CalPlug/EVSE_Smart_Charger/2017-2018 Project/EVSE_Processing_Interface/evse/images/textBox4.jpg

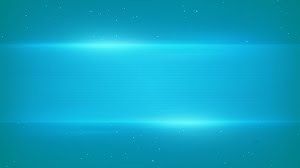
2017-2018 Project/EVSE_Processing_Interface/evse/images/textBox4.jpg
