CalPlug/EVSE_Smart_Charger/2017-2018 Project/Smartenit_Board_I2C/README

This is an updated board and schematics to a more readable format and includes a header for I2C.
