CalPlug/EVSE_Smart_Charger/2017-2018 Project/FPGA Design/Microsemi_SmartFusion2_FutureCreativeBoard_BaseDesign-master/FCBBaseDesign/synthesis/synlog/report/SF2_MSS_sys_fpga_mapper_notes.txt

@N: MF248 |Running in 64-bit mode.
@N: MF667 |Clock conversion disabled. (Command "set_option -fix_gated_and_generated_clocks 0" in the project file.)
@N: MO111 :"c:\users\mike klopfer\documents\github\microsemi_smartfusion2_futurecreativeboard_basedesign\fcbbasedesign\component\actel\directcore\corepwm\4.3.101\rtl\vhdl\core\reg_if.vhd":316:27:316:99|Tristate driver un1_tri7 (in view: corepwm_lib.corepwm_reg_if(trans)) on net un1_tri7 (in view: corepwm_lib.corepwm_reg_if(trans)) has its enable tied to GND.
@N: MO111 :"c:\users\mike klopfer\documents\github\microsemi_smartfusion2_futurecreativeboard_basedesign\fcbbasedesign\component\actel\directcore\corepwm\4.3.101\rtl\vhdl\core\reg_if.vhd":316:27:316:99|Tristate driver un1_tri6 (in view: corepwm_lib.corepwm_reg_if(trans)) on net un1_tri6 (in view: corepwm_lib.corepwm_reg_if(trans)) has its enable tied to GND.
@N: MO111 :"c:\users\mike klopfer\documents\github\microsemi_smartfusion2_futurecreativeboard_basedesign\fcbbasedesign\component\actel\directcore\corepwm\4.3.101\rtl\vhdl\core\reg_if.vhd":316:27:316:99|Tristate driver un1_tri5 (in view: corepwm_lib.corepwm_reg_if(trans)) on net un1_tri5 (in view: corepwm_lib.corepwm_reg_if(trans)) has its enable tied to GND.
@N: MO111 :"c:\users\mike klopfer\documents\github\microsemi_smartfusion2_futurecreativeboard_basedesign\fcbbasedesign\component\actel\directcore\corepwm\4.3.101\rtl\vhdl\core\reg_if.vhd":316:27:316:99|Tristate driver un1_tri4 (in view: corepwm_lib.corepwm_reg_if(trans)) on net un1_tri4 (in view: corepwm_lib.corepwm_reg_if(trans)) has its enable tied to GND.
@N: MO111 :"c:\users\mike klopfer\documents\github\microsemi_smartfusion2_futurecreativeboard_basedesign\fcbbasedesign\component\actel\directcore\corepwm\4.3.101\rtl\vhdl\core\reg_if.vhd":316:27:316:99|Tristate driver un1_tri3 (in view: corepwm_lib.corepwm_reg_if(trans)) on net un1_tri3 (in view: corepwm_lib.corepwm_reg_if(trans)) has its enable tied to GND.
@N: MO111 :"c:\users\mike klopfer\documents\github\microsemi_smartfusion2_futurecreativeboard_basedesign\fcbbasedesign\component\actel\directcore\corepwm\4.3.101\rtl\vhdl\core\reg_if.vhd":316:27:316:99|Tristate driver un1_tri2 (in view: corepwm_lib.corepwm_reg_if(trans)) on net un1_tri2 (in view: corepwm_lib.corepwm_reg_if(trans)) has its enable tied to GND.
@N: MO111 :"c:\users\mike klopfer\documents\github\microsemi_smartfusion2_futurecreativeboard_basedesign\fcbbasedesign\component\actel\directcore\corepwm\4.3.101\rtl\vhdl\core\reg_if.vhd":316:27:316:99|Tristate driver un1_tri1 (in view: corepwm_lib.corepwm_reg_if(trans)) on net un1_tri1 (in view: corepwm_lib.corepwm_reg_if(trans)) has its enable tied to GND.
@N: MO111 :"c:\users\mike klopfer\documents\github\microsemi_smartfusion2_futurecreativeboard_basedesign\fcbbasedesign\component\actel\directcore\corepwm\4.3.101\rtl\vhdl\core\reg_if.vhd":316:27:316:99|Tristate driver un1_tri0 (in view: corepwm_lib.corepwm_reg_if(trans)) on net un1_tri0 (in view: corepwm_lib.corepwm_reg_if(trans)) has its enable tied to GND.
@N: MO111 :"c:\users\mike klopfer\documents\github\microsemi_smartfusion2_futurecreativeboard_basedesign\fcbbasedesign\component\actel\directcore\corepwm\4.3.101\rtl\vhdl\core\reg_if.vhd":314:27:314:98|Tristate driver un1_psh_enable_reg1_tri7 (in view: corepwm_lib.corepwm_reg_if(trans)) on net un1_psh_enable_reg1_tri7 (in view: corepwm_lib.corepwm_reg_if(trans)) has its enable tied to GND.
@N: MO111 :"c:\users\mike klopfer\documents\github\microsemi_smartfusion2_futurecreativeboard_basedesign\fcbbasedesign\component\actel\directcore\corepwm\4.3.101\rtl\vhdl\core\reg_if.vhd":314:27:314:98|Tristate driver un1_psh_enable_reg1_tri6 (in view: corepwm_lib.corepwm_reg_if(trans)) on net un1_psh_enable_reg1_tri6 (in view: corepwm_lib.corepwm_reg_if(trans)) has its enable tied to GND.
@N: MO106 :"c:\users\mike klopfer\documents\github\microsemi_smartfusion2_futurecreativeboard_basedesign\fcbbasedesign\component\actel\directcore\coreapb3\4.1.100\rtl\vhdl\core\coreapb3.vhd":648:12:648:15|Found ROM .delname. (in view: work.SF2_MSS_sys_sb(rtl)) with 16 words by 5 bits.
@N: BN362 :"c:\users\mike klopfer\documents\github\microsemi_smartfusion2_futurecreativeboard_basedesign\fcbbasedesign\component\actel\directcore\corespi\5.1.104\rtl\vhdl\core\spi_chanctrl.vhd":371:8:371:9|Removing sequential instance mtx_consecutive (in view: corespi_lib.spi_chanctrl(trans)) of type view:PrimLib.dffre(prim) because it does not drive other instances.
@N: MF135 :"c:\users\mike klopfer\documents\github\microsemi_smartfusion2_futurecreativeboard_basedesign\fcbbasedesign\component\actel\directcore\coregpio\3.1.101\rtl\vhdl\core\coregpio.vhd":521:8:521:9|RAM GEN_BITS\.0\.REG_GEN\.CONFIG_reg[7:0] (in view: coregpio_lib.CoreGPIO(rtl)) is 16 words by 8 bits.
@N: BN362 :"c:\users\mike klopfer\documents\github\microsemi_smartfusion2_futurecreativeboard_basedesign\fcbbasedesign\component\actel\directcore\coregpio\3.1.101\rtl\vhdl\core\coregpio.vhd":521:8:521:9|Removing sequential instance CONFIG_reg_0[2] (in view: coregpio_lib.CoreGPIO(rtl)) of type view:PrimLib.dffr(prim) because it does not drive other instances.
@N: BN362 :"c:\users\mike klopfer\documents\github\microsemi_smartfusion2_futurecreativeboard_basedesign\fcbbasedesign\component\actel\directcore\coregpio\3.1.101\rtl\vhdl\core\coregpio.vhd":521:8:521:9|Removing sequential instance CONFIG_reg_1[2] (in view: coregpio_lib.CoreGPIO(rtl)) of type view:PrimLib.dffr(prim) because it does not drive other instances.
@N: BN362 :"c:\users\mike klopfer\documents\github\microsemi_smartfusion2_futurecreativeboard_basedesign\fcbbasedesign\component\actel\directcore\coregpio\3.1.101\rtl\vhdl\core\coregpio.vhd":521:8:521:9|Removing sequential instance CONFIG_reg_2[2] (in view: coregpio_lib.CoreGPIO(rtl)) of type view:PrimLib.dffr(prim) because it does not drive other instances.
@N: BN362 :"c:\users\mike klopfer\documents\github\microsemi_smartfusion2_futurecreativeboard_basedesign\fcbbasedesign\component\actel\directcore\coregpio\3.1.101\rtl\vhdl\core\coregpio.vhd":521:8:521:9|Removing sequential instance CONFIG_reg_3[2] (in view: coregpio_lib.CoreGPIO(rtl)) of type view:PrimLib.dffr(prim) because it does not drive other instances.
@N: BN362 :"c:\users\mike klopfer\documents\github\microsemi_smartfusion2_futurecreativeboard_basedesign\fcbbasedesign\component\actel\directcore\coregpio\3.1.101\rtl\vhdl\core\coregpio.vhd":521:8:521:9|Removing sequential instance CONFIG_reg_4[2] (in view: coregpio_lib.CoreGPIO(rtl)) of type view:PrimLib.dffr(prim) because it does not drive other instances.
@N: BN362 :"c:\users\mike klopfer\documents\github\microsemi_smartfusion2_futurecreativeboard_basedesign\fcbbasedesign\component\actel\directcore\coregpio\3.1.101\rtl\vhdl\core\coregpio.vhd":521:8:521:9|Removing sequential instance CONFIG_reg_5[2] (in view: coregpio_lib.CoreGPIO(rtl)) of type view:PrimLib.dffr(prim) because it does not drive other instances.
@N: BN362 :"c:\users\mike klopfer\documents\github\microsemi_smartfusion2_futurecreativeboard_basedesign\fcbbasedesign\component\actel\directcore\coregpio\3.1.101\rtl\vhdl\core\coregpio.vhd":521:8:521:9|Removing sequential instance CONFIG_reg_6[2] (in view: coregpio_lib.CoreGPIO(rtl)) of type view:PrimLib.dffr(prim) because it does not drive other instances.
@N: BN362 :"c:\users\mike klopfer\documents\github\microsemi_smartfusion2_futurecreativeboard_basedesign\fcbbasedesign\component\actel\directcore\coregpio\3.1.101\rtl\vhdl\core\coregpio.vhd":521:8:521:9|Removing sequential instance CONFIG_reg_7[2] (in view: coregpio_lib.CoreGPIO(rtl)) of type view:PrimLib.dffr(prim) because it does not drive other instances.
@N: BN362 :"c:\users\mike klopfer\documents\github\microsemi_smartfusion2_futurecreativeboard_basedesign\fcbbasedesign\component\actel\directcore\coregpio\3.1.101\rtl\vhdl\core\coregpio.vhd":521:8:521:9|Removing sequential instance CONFIG_reg_8[2] (in view: coregpio_lib.CoreGPIO(rtl)) of type view:PrimLib.dffr(prim) because it does not drive other instances.
@N: BN362 :"c:\users\mike klopfer\documents\github\microsemi_smartfusion2_futurecreativeboard_basedesign\fcbbasedesign\component\actel\directcore\coregpio\3.1.101\rtl\vhdl\core\coregpio.vhd":521:8:521:9|Removing sequential instance CONFIG_reg_9[2] (in view: coregpio_lib.CoreGPIO(rtl)) of type view:PrimLib.dffr(prim) because it does not drive other instances.
@N: BN362 :"c:\users\mike klopfer\documents\github\microsemi_smartfusion2_futurecreativeboard_basedesign\fcbbasedesign\component\actel\directcore\coregpio\3.1.101\rtl\vhdl\core\coregpio.vhd":521:8:521:9|Removing sequential instance CONFIG_reg_10[2] (in view: coregpio_lib.CoreGPIO(rtl)) of type view:PrimLib.dffr(prim) because it does not drive other instances.
@N: BN362 :"c:\users\mike klopfer\documents\github\microsemi_smartfusion2_futurecreativeboard_basedesign\fcbbasedesign\component\actel\directcore\coregpio\3.1.101\rtl\vhdl\core\coregpio.vhd":521:8:521:9|Removing sequential instance CONFIG_reg_11[2] (in view: coregpio_lib.CoreGPIO(rtl)) of type view:PrimLib.dffr(prim) because it does not drive other instances.
@N: MO231 :"c:\users\mike klopfer\documents\github\microsemi_smartfusion2_futurecreativeboard_basedesign\fcbbasedesign\component\actel\directcore\corepwm\4.3.101\rtl\vhdl\core\timebase.vhd":75:6:75:7|Found counter in view:corepwm_lib.corepwm_timebase(trans) instance period_cnt_int[15:0] 
@N: MO231 :"c:\users\mike klopfer\documents\github\microsemi_smartfusion2_futurecreativeboard_basedesign\fcbbasedesign\component\actel\directcore\corepwm\4.3.101\rtl\vhdl\core\timebase.vhd":58:6:58:7|Found counter in view:corepwm_lib.corepwm_timebase(trans) instance prescale_cnt[15:0] 
@N: MF179 :"c:\users\mike klopfer\documents\github\microsemi_smartfusion2_futurecreativeboard_basedesign\fcbbasedesign\component\actel\directcore\corepwm\4.3.101\rtl\vhdl\core\timebase.vhd":83:19:83:45|Found 16 by 16 bit equality operator ('==') un17_prescale_cnt (in view: corepwm_lib.corepwm_timebase(trans))
@N: MF179 :"c:\users\mike klopfer\documents\github\microsemi_smartfusion2_futurecreativeboard_basedesign\fcbbasedesign\component\actel\directcore\corepwm\4.3.101\rtl\vhdl\core\pwm_gen.vhd":75:26:75:154|Found 16 by 16 bit equality operator ('==') PWM_output_select\.1\.PWM_output_generation\.un11_pwm_enable_reg (in view: corepwm_lib.corepwm_pwm_gen(trans))
@N: MF179 :"c:\users\mike klopfer\documents\github\microsemi_smartfusion2_futurecreativeboard_basedesign\fcbbasedesign\component\actel\directcore\corepwm\4.3.101\rtl\vhdl\core\pwm_gen.vhd":75:163:75:239|Found 16 by 16 bit equality operator ('==') PWM_output_select\.1\.PWM_output_generation\.un14_pwm_enable_reg (in view: corepwm_lib.corepwm_pwm_gen(trans))
@N: MF179 :"c:\users\mike klopfer\documents\github\microsemi_smartfusion2_futurecreativeboard_basedesign\fcbbasedesign\component\actel\directcore\corepwm\4.3.101\rtl\vhdl\core\pwm_gen.vhd":75:26:75:154|Found 16 by 16 bit equality operator ('==') PWM_output_select\.2\.PWM_output_generation\.un49_pwm_enable_reg (in view: corepwm_lib.corepwm_pwm_gen(trans))
@N: MF179 :"c:\users\mike klopfer\documents\github\microsemi_smartfusion2_futurecreativeboard_basedesign\fcbbasedesign\component\actel\directcore\corepwm\4.3.101\rtl\vhdl\core\pwm_gen.vhd":75:163:75:239|Found 16 by 16 bit equality operator ('==') PWM_output_select\.2\.PWM_output_generation\.un52_pwm_enable_reg (in view: corepwm_lib.corepwm_pwm_gen(trans))
@N: MF179 :"c:\users\mike klopfer\documents\github\microsemi_smartfusion2_futurecreativeboard_basedesign\fcbbasedesign\component\actel\directcore\corepwm\4.3.101\rtl\vhdl\core\pwm_gen.vhd":75:26:75:154|Found 16 by 16 bit equality operator ('==') PWM_output_select\.3\.PWM_output_generation\.un87_pwm_enable_reg (in view: corepwm_lib.corepwm_pwm_gen(trans))
@N: MF179 :"c:\users\mike klopfer\documents\github\microsemi_smartfusion2_futurecreativeboard_basedesign\fcbbasedesign\component\actel\directcore\corepwm\4.3.101\rtl\vhdl\core\pwm_gen.vhd":75:163:75:239|Found 16 by 16 bit equality operator ('==') PWM_output_select\.3\.PWM_output_generation\.un90_pwm_enable_reg (in view: corepwm_lib.corepwm_pwm_gen(trans))
@N: MF179 :"c:\users\mike klopfer\documents\github\microsemi_smartfusion2_futurecreativeboard_basedesign\fcbbasedesign\component\actel\directcore\corepwm\4.3.101\rtl\vhdl\core\pwm_gen.vhd":79:82:79:158|Found 16 by 16 bit equality operator ('==') PWM_output_select\.1\.PWM_output_generation\.un31_pwm_enable_reg (in view: corepwm_lib.corepwm_pwm_gen(trans))
@N: MF179 :"c:\users\mike klopfer\documents\github\microsemi_smartfusion2_futurecreativeboard_basedesign\fcbbasedesign\component\actel\directcore\corepwm\4.3.101\rtl\vhdl\core\pwm_gen.vhd":79:82:79:158|Found 16 by 16 bit equality operator ('==') PWM_output_select\.2\.PWM_output_generation\.un69_pwm_enable_reg (in view: corepwm_lib.corepwm_pwm_gen(trans))
@N: MF179 :"c:\users\mike klopfer\documents\github\microsemi_smartfusion2_futurecreativeboard_basedesign\fcbbasedesign\component\actel\directcore\corepwm\4.3.101\rtl\vhdl\core\pwm_gen.vhd":79:82:79:158|Found 16 by 16 bit equality operator ('==') PWM_output_select\.3\.PWM_output_generation\.un107_pwm_enable_reg (in view: corepwm_lib.corepwm_pwm_gen(trans))
@N: MO231 :"c:\users\mike klopfer\documents\github\microsemi_smartfusion2_futurecreativeboard_basedesign\fcbbasedesign\component\actel\directcore\corespi\5.1.104\rtl\vhdl\core\spi_chanctrl.vhd":683:8:683:9|Found counter in view:corespi_lib.spi_chanctrl(trans) instance stxs_bitcnt[4:0] 
@N: MO231 :"c:\users\mike klopfer\documents\github\microsemi_smartfusion2_futurecreativeboard_basedesign\fcbbasedesign\component\actel\directcore\corespi\5.1.104\rtl\vhdl\core\spi_chanctrl.vhd":683:8:683:9|Found counter in view:corespi_lib.spi_chanctrl(trans) instance stxs_bitsel[4:0] 
@N: MO231 :"c:\users\mike klopfer\documents\github\microsemi_smartfusion2_futurecreativeboard_basedesign\fcbbasedesign\component\actel\directcore\corespi\5.1.104\rtl\vhdl\core\spi_chanctrl.vhd":371:8:371:9|Found counter in view:corespi_lib.spi_chanctrl(trans) instance mtx_bitsel[4:0] 
@N: MO231 :"c:\users\mike klopfer\documents\github\microsemi_smartfusion2_futurecreativeboard_basedesign\fcbbasedesign\component\actel\directcore\corespi\5.1.104\rtl\vhdl\core\spi_chanctrl.vhd":270:8:270:9|Found counter in view:corespi_lib.spi_chanctrl(trans) instance spi_clk_count[7:0] 
@N: MO225 :"c:\users\mike klopfer\documents\github\microsemi_smartfusion2_futurecreativeboard_basedesign\fcbbasedesign\component\work\sf2_mss_sys_sb\coreuartapb_0\rtl\vhdl\core\coreuart.vhd":367:6:367:7|There are no possible illegal states for state machine rx_state[0:3] (in view: coreuartapb_lib.SF2_MSS_sys_sb_CoreUARTapb_0_COREUART(translated)); safe FSM implementation is not required.
@N: FX403 :"c:\users\mike klopfer\documents\github\microsemi_smartfusion2_futurecreativeboard_basedesign\fcbbasedesign\component\work\sf2_mss_sys_sb\coreuartapb_0\rtl\vhdl\core\fifo_256x8.vhd":343:10:343:15|Property "block_ram" or "no_rw_check" found for RAM UG07\.rx_fifo_xhdl80.fifo_ctrl_256_xhdl9.ram16x8_xhdl12.memory_xhdl3[7:0] with specified coding style. Inferring block RAM.
@N: FX403 :"c:\users\mike klopfer\documents\github\microsemi_smartfusion2_futurecreativeboard_basedesign\fcbbasedesign\component\work\sf2_mss_sys_sb\coreuartapb_0\rtl\vhdl\core\fifo_256x8.vhd":343:10:343:15|Property "block_ram" or "no_rw_check" found for RAM UG06a\.tx_fifo_xhdl79.fifo_ctrl_256_xhdl9.ram16x8_xhdl12.memory_xhdl3[7:0] with specified coding style. Inferring block RAM.
@N: MO231 :"c:\users\mike klopfer\documents\github\microsemi_smartfusion2_futurecreativeboard_basedesign\fcbbasedesign\component\work\sf2_mss_sys_sb\coreuartapb_0\rtl\vhdl\core\clock_gen.vhd":214:11:214:12|Found counter in view:coreuartapb_lib.SF2_MSS_sys_sb_CoreUARTapb_0_Clock_gen(rtl) instance baud_cntr[12:0] 
@N: MO225 :"c:\users\mike klopfer\documents\github\microsemi_smartfusion2_futurecreativeboard_basedesign\fcbbasedesign\component\work\sf2_mss_sys_sb\coreuartapb_0\rtl\vhdl\core\rx_async.vhd":264:6:264:7|There are no possible illegal states for state machine rx_state[0:3] (in view: coreuartapb_lib.SF2_MSS_sys_sb_CoreUARTapb_0_Rx_async(translated)); safe FSM implementation is not required.
@N: BN362 :"c:\users\mike klopfer\documents\github\microsemi_smartfusion2_futurecreativeboard_basedesign\fcbbasedesign\component\actel\directcore\corespi\5.1.104\rtl\vhdl\core\spi_chanctrl.vhd":270:8:270:9|Removing sequential instance SF2_MSS_sys_sb_0.CORESPI_0.USPI.UCC.spi_clk_next (in view: work.SF2_MSS_sys(rtl)) because it does not drive other instances.
@N: BN362 :"c:\users\mike klopfer\documents\github\microsemi_smartfusion2_futurecreativeboard_basedesign\fcbbasedesign\component\actel\directcore\corei2c\7.2.101\rtl\vhdl\core\corei2creal.vhd":1553:8:1553:9|Removing sequential instance SF2_MSS_sys_sb_0.COREI2C_0.G0a\.0\.ui2c.fsmsync[0] (in view: work.SF2_MSS_sys(rtl)) because it does not drive other instances.
@N: BN362 :|Removing sequential instance SF2_MSS_sys_sb_0.CoreUARTapb_0.uUART.UG06a\.tx_fifo_xhdl79.fifo_ctrl_256_xhdl9.ram16x8_xhdl12.memory_xhdl3_memory_xhdl3_0_0_R[0] (in view: work.SF2_MSS_sys(rtl)) of type view:ACG4.SLE(PRIM) because it does not drive other instances.
@N: BN362 :|Removing sequential instance SF2_MSS_sys_sb_0.CoreUARTapb_0.uUART.UG06a\.tx_fifo_xhdl79.fifo_ctrl_256_xhdl9.ram16x8_xhdl12.memory_xhdl3_memory_xhdl3_0_0_R[1] (in view: work.SF2_MSS_sys(rtl)) of type view:ACG4.SLE(PRIM) because it does not drive other instances.
@N: BN362 :|Removing sequential instance SF2_MSS_sys_sb_0.CoreUARTapb_0.uUART.UG06a\.tx_fifo_xhdl79.fifo_ctrl_256_xhdl9.ram16x8_xhdl12.memory_xhdl3_memory_xhdl3_0_0_R[2] (in view: work.SF2_MSS_sys(rtl)) of type view:ACG4.SLE(PRIM) because it does not drive other instances.
@N: BN362 :|Removing sequential instance SF2_MSS_sys_sb_0.CoreUARTapb_0.uUART.UG06a\.tx_fifo_xhdl79.fifo_ctrl_256_xhdl9.ram16x8_xhdl12.memory_xhdl3_memory_xhdl3_0_0_R[3] (in view: work.SF2_MSS_sys(rtl)) of type view:ACG4.SLE(PRIM) because it does not drive other instances.
@N: BN362 :|Removing sequential instance SF2_MSS_sys_sb_0.CoreUARTapb_0.uUART.UG06a\.tx_fifo_xhdl79.fifo_ctrl_256_xhdl9.ram16x8_xhdl12.memory_xhdl3_memory_xhdl3_0_0_R[4] (in view: work.SF2_MSS_sys(rtl)) of type view:ACG4.SLE(PRIM) because it does not drive other instances.
@N: BN362 :|Removing sequential instance SF2_MSS_sys_sb_0.CoreUARTapb_0.uUART.UG06a\.tx_fifo_xhdl79.fifo_ctrl_256_xhdl9.ram16x8_xhdl12.memory_xhdl3_memory_xhdl3_0_0_R[5] (in view: work.SF2_MSS_sys(rtl)) of type view:ACG4.SLE(PRIM) because it does not drive other instances.
@N: BN362 :|Removing sequential instance SF2_MSS_sys_sb_0.CoreUARTapb_0.uUART.UG06a\.tx_fifo_xhdl79.fifo_ctrl_256_xhdl9.ram16x8_xhdl12.memory_xhdl3_memory_xhdl3_0_0_R[6] (in view: work.SF2_MSS_sys(rtl)) of type view:ACG4.SLE(PRIM) because it does not drive other instances.
@N: BN362 :|Removing sequential instance SF2_MSS_sys_sb_0.CoreUARTapb_0.uUART.UG06a\.tx_fifo_xhdl79.fifo_ctrl_256_xhdl9.ram16x8_xhdl12.memory_xhdl3_memory_xhdl3_0_0_R[7] (in view: work.SF2_MSS_sys(rtl)) of type view:ACG4.SLE(PRIM) because it does not drive other instances.
@N: BN362 :|Removing sequential instance SF2_MSS_sys_sb_0.CoreUARTapb_0.uUART.UG07\.rx_fifo_xhdl80.fifo_ctrl_256_xhdl9.ram16x8_xhdl12.memory_xhdl3_memory_xhdl3_0_0_R[0] (in view: work.SF2_MSS_sys(rtl)) of type view:ACG4.SLE(PRIM) because it does not drive other instances.
@N: BN362 :|Removing sequential instance SF2_MSS_sys_sb_0.CoreUARTapb_0.uUART.UG07\.rx_fifo_xhdl80.fifo_ctrl_256_xhdl9.ram16x8_xhdl12.memory_xhdl3_memory_xhdl3_0_0_R[1] (in view: work.SF2_MSS_sys(rtl)) of type view:ACG4.SLE(PRIM) because it does not drive other instances.
@N: BN362 :|Removing sequential instance SF2_MSS_sys_sb_0.CoreUARTapb_0.uUART.UG07\.rx_fifo_xhdl80.fifo_ctrl_256_xhdl9.ram16x8_xhdl12.memory_xhdl3_memory_xhdl3_0_0_R[2] (in view: work.SF2_MSS_sys(rtl)) of type view:ACG4.SLE(PRIM) because it does not drive other instances.
@N: BN362 :|Removing sequential instance SF2_MSS_sys_sb_0.CoreUARTapb_0.uUART.UG07\.rx_fifo_xhdl80.fifo_ctrl_256_xhdl9.ram16x8_xhdl12.memory_xhdl3_memory_xhdl3_0_0_R[3] (in view: work.SF2_MSS_sys(rtl)) of type view:ACG4.SLE(PRIM) because it does not drive other instances.
@N: BN362 :|Removing sequential instance SF2_MSS_sys_sb_0.CoreUARTapb_0.uUART.UG07\.rx_fifo_xhdl80.fifo_ctrl_256_xhdl9.ram16x8_xhdl12.memory_xhdl3_memory_xhdl3_0_0_R[4] (in view: work.SF2_MSS_sys(rtl)) of type view:ACG4.SLE(PRIM) because it does not drive other instances.
@N: BN362 :|Removing sequential instance SF2_MSS_sys_sb_0.CoreUARTapb_0.uUART.UG07\.rx_fifo_xhdl80.fifo_ctrl_256_xhdl9.ram16x8_xhdl12.memory_xhdl3_memory_xhdl3_0_0_R[5] (in view: work.SF2_MSS_sys(rtl)) of type view:ACG4.SLE(PRIM) because it does not drive other instances.
@N: BN362 :|Removing sequential instance SF2_MSS_sys_sb_0.CoreUARTapb_0.uUART.UG07\.rx_fifo_xhdl80.fifo_ctrl_256_xhdl9.ram16x8_xhdl12.memory_xhdl3_memory_xhdl3_0_0_R[6] (in view: work.SF2_MSS_sys(rtl)) of type view:ACG4.SLE(PRIM) because it does not drive other instances.
@N: BN362 :|Removing sequential instance SF2_MSS_sys_sb_0.CoreUARTapb_0.uUART.UG07\.rx_fifo_xhdl80.fifo_ctrl_256_xhdl9.ram16x8_xhdl12.memory_xhdl3_memory_xhdl3_0_0_R[7] (in view: work.SF2_MSS_sys(rtl)) of type view:ACG4.SLE(PRIM) because it does not drive other instances.
@N: FP130 |Promoting Net SF2_MSS_sys_sb_0.MSS_READY on CLKINT  I_210 
@N: FX1056 |Writing EDF file: C:\Users\Mike Klopfer\Documents\GitHub\Microsemi_SmartFusion2_FutureCreativeBoard_BaseDesign\FCBBaseDesign\synthesis\SF2_MSS_sys.edn
@N: BW103 |The default time unit for the Synopsys Constraint File (SDC or FDC) is 1ns.
@N: BW107 |Synopsys Constraint File capacitance units using default value of 1pF 
@N: MT615 |Found clock SF2_MSS_sys_sb_0/FABOSC_0/I_RCOSC_25_50MHZ/CLKOUT with period 20.00ns 
@N: MT615 |Found clock SF2_MSS_sys_sb_0/CCC_0/GL0 with period 14.29ns 
@N: MT615 |Found clock SF2_MSS_sys_sb_0/CCC_0/GL1 with period 1000.00ns 
@N: MT320 |This timing report is an estimate of place and route data. For final timing results, use the FPGA vendor place and route report.
@N: MT322 |Clock constraints include only register-to-register paths associated with each individual clock.
@N: MT582 |Estimated period and frequency not reported for given clock unless the clock has at least one timing path which is not a false or a max delay path and that does not have excessive slack
