CalPlug/EVSE_Smart_Charger/2017-2018 Project/FPGA Design/Microsemi_SmartFusion2_FutureCreativeBoard_BaseDesign-master/FCBBaseDesign/synthesis/synlog/report/SF2_MSS_sys_fpga_mapper_hier_area.csv

. Module name | SLE | CFG | ARI1 | BUFFER | MACC | RAM1K18 | RAM64X18 | GLOBAL | IO
. SF2_MSS_sys | 970 | 1561 | 237 | 0 | 0 | 0 | 9 | 4 | 52
. . SF2_MSS_sys_sb | 970 | 1561 | 237 | 0 | 0 | 0 | 9 | 4 | 2
. . . CoreAPB3 | 0 | 286 | 0 | 0 | 0 | 0 | 0 | 0 | 0
. . . . COREAPB3_MUXPTOB3 | 0 | 282 | 0 | 0 | 0 | 0 | 0 | 0 | 0
. . . CoreGPIO | 180 | 301 | 0 | 0 | 0 | 0 | 1 | 0 | 0
. . . CoreResetP | 9 | 2 | 0 | 0 | 0 | 0 | 0 | 1 | 0
. . . SF2_MSS_sys_sb_CCC_0_FCCC | 0 | 0 | 0 | 0 | 0 | 0 | 0 | 3 | 0
. . . SF2_MSS_sys_sb_COREI2C_0_COREI2C | 119 | 344 | 0 | 0 | 0 | 0 | 0 | 0 | 0
. . . . COREI2C_COREI2CREAL | 111 | 342 | 0 | 0 | 0 | 0 | 0 | 0 | 0
. . . SF2_MSS_sys_sb_CoreUARTapb_0_CoreUARTapb | 171 | 212 | 19 | 0 | 0 | 0 | 2 | 0 | 0
. . . . SF2_MSS_sys_sb_CoreUARTapb_0_COREUART | 147 | 175 | 19 | 0 | 0 | 0 | 2 | 0 | 0
. . . . . SF2_MSS_sys_sb_CoreUARTapb_0_Clock_gen | 19 | 10 | 14 | 0 | 0 | 0 | 0 | 0 | 0
. . . . . SF2_MSS_sys_sb_CoreUARTapb_0_Rx_async | 39 | 74 | 0 | 0 | 0 | 0 | 0 | 0 | 0
. . . . . SF2_MSS_sys_sb_CoreUARTapb_0_Tx_async | 23 | 24 | 5 | 0 | 0 | 0 | 0 | 0 | 0
. . . . . SF2_MSS_sys_sb_CoreUARTapb_0_fifo_256x8 | 21 | 21 | 0 | 0 | 0 | 0 | 1 | 0 | 0
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
