CalPlug/EVSE_Smart_Charger/2016 Project/EVSE_DEMO_MATLAB_GUI/PC EVSE DEMO/OpenEVSE_RAPI_Processing_GUI/RGB_LCD.jpg

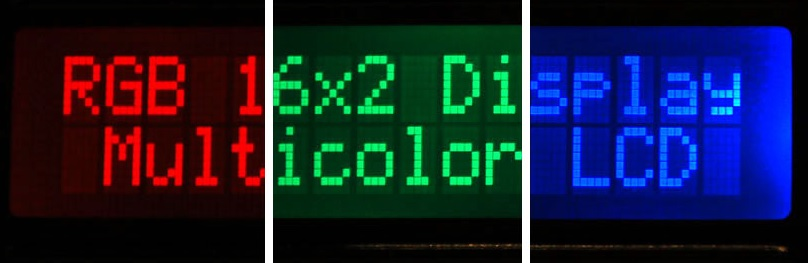
2016 Project/EVSE_DEMO_MATLAB_GUI/PC EVSE DEMO/OpenEVSE_RAPI_Processing_GUI/RGB_LCD.jpg
