CalPlug/EVSE_Smart_Charger/2017-2018 Project/EVSE code/Arduino/MQTT_example.png

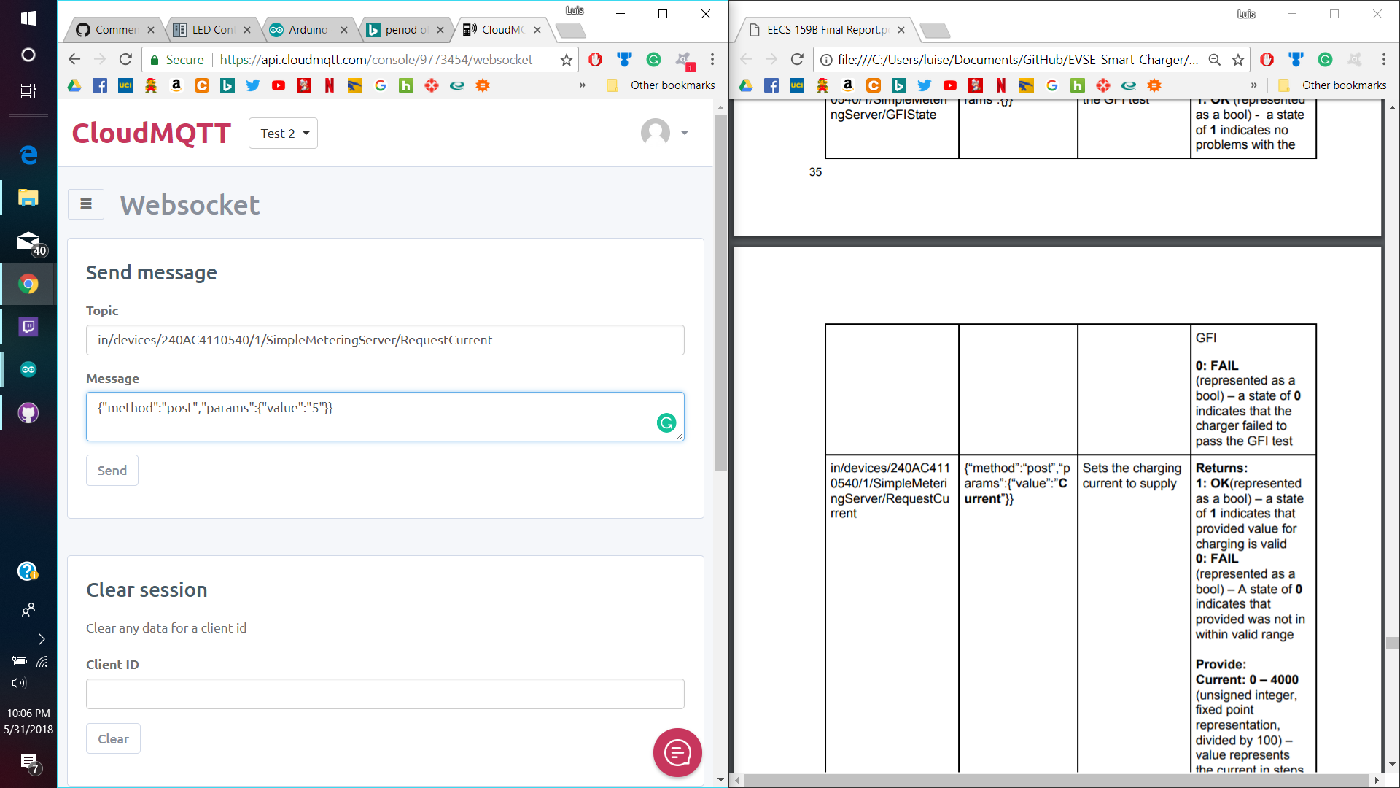
2017-2018 Project/EVSE code/Arduino/MQTT_example.png
