CalPlug/EVSE_Smart_Charger/2017-2018 Project/EVSE Smart Charger Circuity Design.jpg

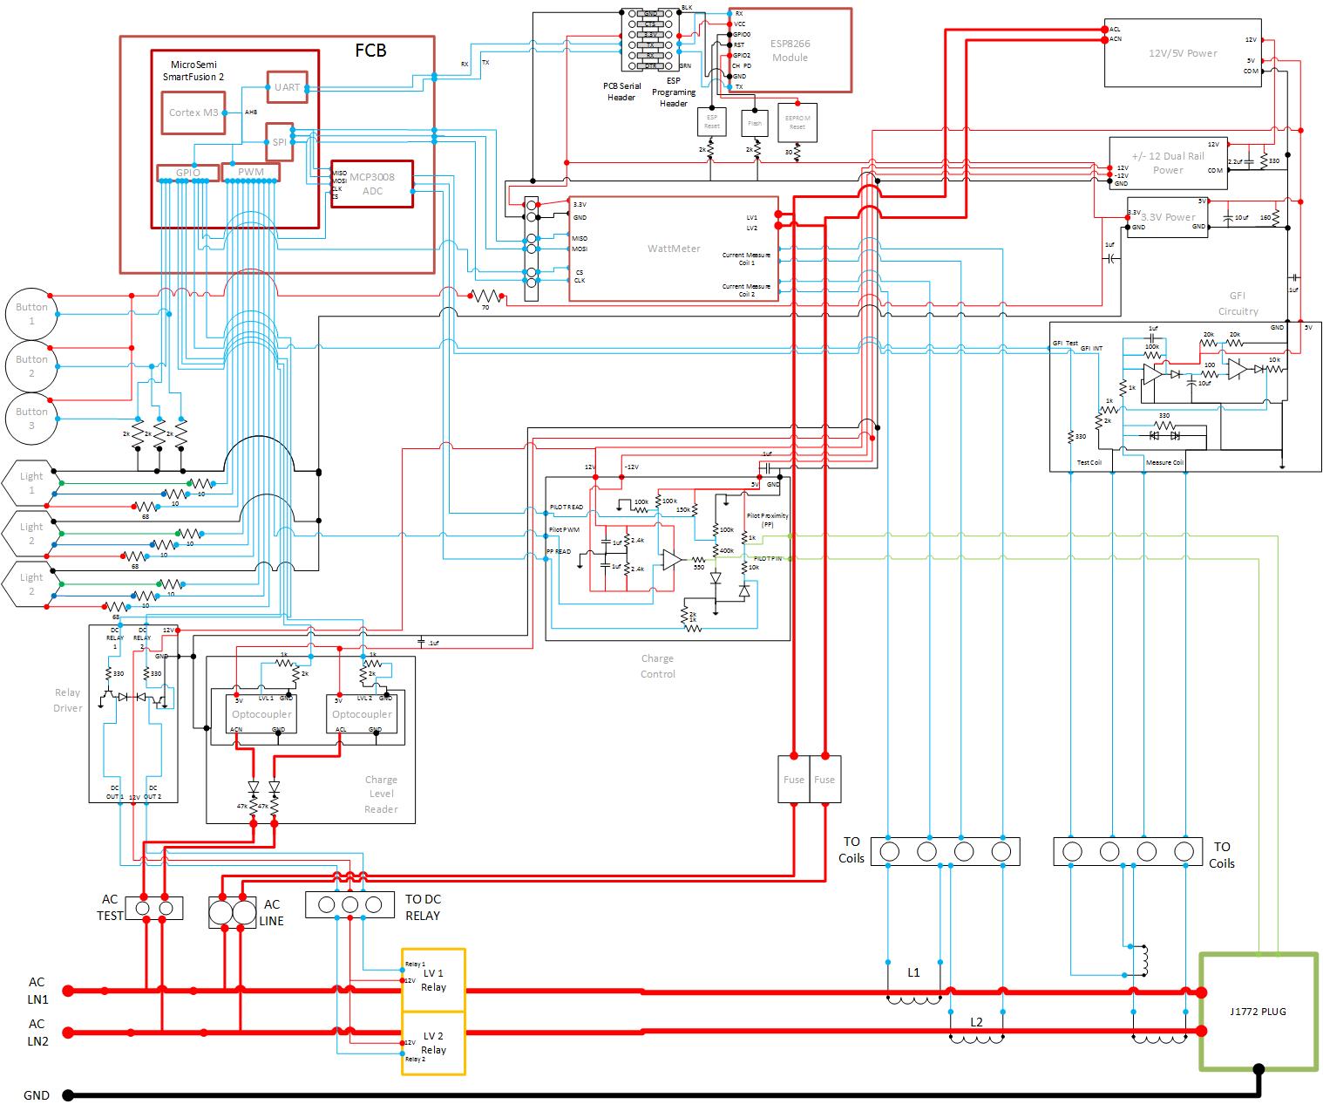
2017-2018 Project/EVSE Smart Charger Circuity Design.jpg
