CalPlug/EVSE_Smart_Charger/2017-2018 Project/EVSE_Processing_Interface/evse/images/on.png

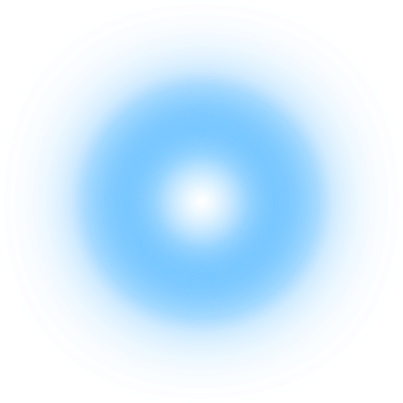
2017-2018 Project/EVSE_Processing_Interface/evse/images/on.png
