CalPlug/EVSE_Smart_Charger/2017-2018 Project/FPGA Design/Microsemi_SmartFusion2_FutureCreativeBoard_BaseDesign-master/Documentation/Microsemi_Future_Electronics_Board_Launch_Block_Diagram_2016_09.jpg

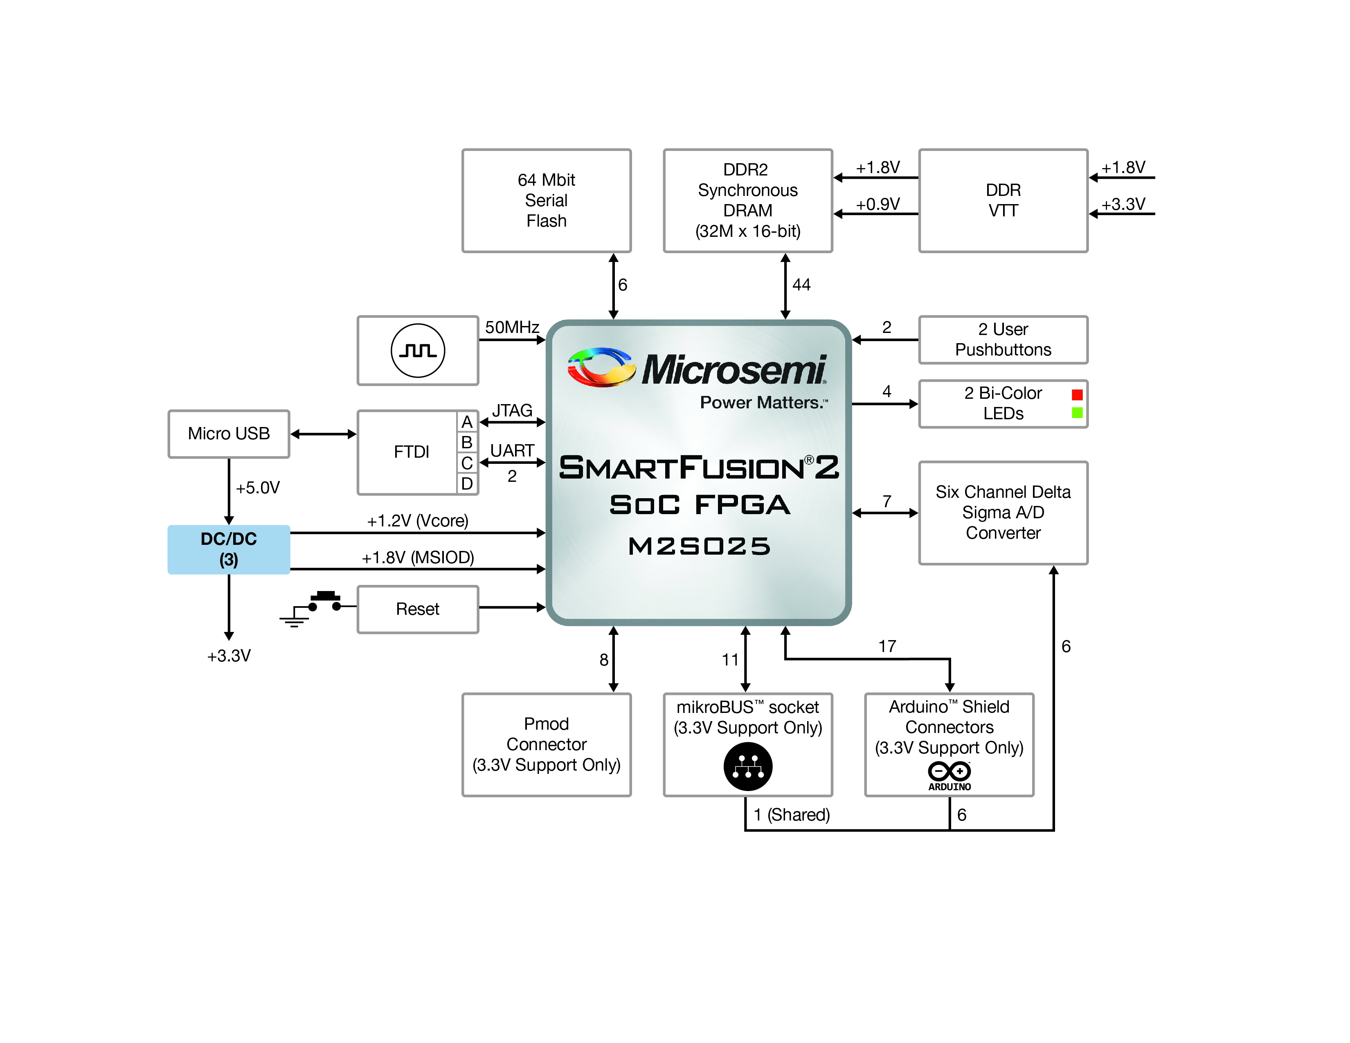
2017-2018 Project/FPGA Design/Microsemi_SmartFusion2_FutureCreativeBoard_BaseDesign-master/Documentation/Microsemi_Future_Electronics_Board_Launch_Block_Diagram_2016_09.jpg
