CalPlug/EVSE_Smart_Charger/EVSE code/Arduino/Documents/Libraries.PNG

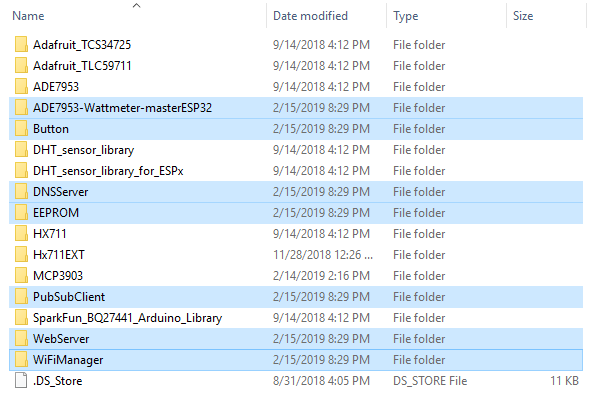
EVSE code/Arduino/Documents/Libraries.PNG
