CalPlug/EVSE_Smart_Charger/2017-2018 Project/Smartenit_Board_I2C/Smartenit Board BOM (1) (1).xlsx

Sheet: Full BOM
Smartenit Board BoM
Qty | Value | Device | Package | Parts | URL | Price per unit | Total quantity (5 boards) | Price (5 boards) | TOTAL
1 | 1 uF, 25V | Capacitor | 603 | C1 | https://www.mouser.com/ProductDetail/AVX/0603DC105MAT2A | 0.251 | 10 | 2.51
6 | 100 nF | Capacitor | 402 | C3, C5,C9, C10, C13, C16 | https://www.mouser.com/ProductDetail/Taiyo-Yuden/LMK105BJ104MC-F | 0.102 | 30 | 1.02
3 | 100nF | Capacitor | 603 | C21,C23, C25 | https://www.mouser.com/ProductDetail/AVX/MM035C104KCZ2A | 1.51 | 15 | 22.65
2 | 20 pF | Capacitor | 402 | C7, C8 | https://www.mouser.com/ProductDetail/KEMET/CBR04C200F2GAC | 0.554 | 10 | 5.54
2 | 10 uF Polarized | Capacitor | 805 | C2, C22 | https://www.mouser.com/ProductDetail/KEMET/T529P106M010AAE200 | 0.459 | 10 | 4.59
4 | 33 nF | Capacitor | 402 | C4, C14, C17, C18 | https://www.mouser.com/ProductDetail/KEMET/C0402C333K3RACAUTO | 0.133 | 20 | 2.66
2 | 33 nF | Capacitor | 805 | C19, C20 | https://www.mouser.com/ProductDetail/KEMET/C0805C333G8JACTU | 0.38 | 10 | 3.8
1 | 22uF/ 6.3V | Capacitor | 603 | C6 | https://www.mouser.com/ProductDetail/Murata-Electronics/GRT188R60J226ME13D | 0.36 | 10 | 3.6
3 | 4.7 uF | Capacitor | 402 | C11, C12, C15 | https://www.mouser.com/ProductDetail/AVX/0402ZD475KAT2A | 0.213 | 15 | 3.195
1 | 150 pF | Capacitor | 603 | C26 | https://www.mouser.com/ProductDetail/KEMET/C0603C151K5RACTU?qs=sGAEpiMZZMs0AnBnWHyRQCTbZkhRx37bxzObmzsa0pg%3d | 0.122 | 10 | 1.22
1 | 100 uF polarized | Capacitor | PTH | C24 | https://www.mouser.com/ProductDetail/Nichicon/URS1E101MDD?qs=sGAEpiMZZMtZ1n0r9vR22Xsgo43SDd6qbF6qX3qWQWE%3d | 0.195 | 10 | 1.95
5 | 10K | Resistor | 603 | R1, R10, R11, R38,R39 | https://www.mouser.com/ProductDetail/Vishay-BC-Components/MCT0603PD1002DP500 | 0.434 | 25 | 10.85
1 | 10K | Resistor | 402 | R22, | https://www.mouser.com/ProductDetail/Vishay/CRCW040210K0FKEDC | 0.041 | 10 | 0.41
1 | 56K | Resistor | 603 | R2 | https://www.mouser.com/ProductDetail/Panasonic/ERJ-S03J563V | 0.23 | 10 | 2.3
1 | 200K | Resistor | 603 | R3 | https://www.mouser.com/ProductDetail/Panasonic/ERJ-P03F2003V?qs=sGAEpiMZZMvdGkrng054tzSGWtpoOZZIMsPP8ce52zM%3d | 0.231 | 10 | 2.31
3 | 1K | Resistor | 603 | R4, R8, R13, | https://www.mouser.com/ProductDetail/KOA-Speer/RK73G1JTTD1001C | 0.367 | 15 | 5.51
4 | 1K | Resistor | 402 | R17, R21, R24, R26 | https://www.mouser.com/ProductDetail/KOA-Speer/RK73G1ETTP1001C | 0.367 | 20 | 7.34
2 | 1K | Resistor | 805 | R23, R31 | https://www.mouser.com/ProductDetail/Vishay/RCS08051K00JNEA | 0.19 | 10 | 1.9
4 | 470 | Resistor | 402 | R5, R7, R14, R15 | https://www.mouser.com/ProductDetail/Panasonic/ERJ-PA2D4700X | 0.2 | 20 | 4
3 | 12K | Resistor | 402 | R6, R16, R32 | https://www.mouser.com/ProductDetail/Panasonic/ERA-2AEB123X?qs=sGAEpiMZZMvdGkrng054t8sBRtayFjgRL6Dhtf0uAlQ%3d | 0.585 | 15 | 8.78
4 | 4.7K | Resistor | 603 | R9, R12,R43,R44 | https://www.mouser.com/ProductDetail/KOA-Speer/RK73G1JTTD4701C | 0.367 | 10 | 3.67
4 | 9.1K | Resistor | 402 | R18, R25, R27, R28 | https://www.mouser.com/ProductDetail/Panasonic/ERA-2AEB912X | 0.585 | 20 | 11.7
4 | 51 | Resistor | 402 | R19, R20, R29, R30 | https://www.mouser.com/ProductDetail/Panasonic/ERJ-PA2D51R0X | 0.2 | 20 | 4
3 | 220 | Resistor | 603 | R33, R41, R42 | https://www.mouser.com/ProductDetail/Panasonic/ERJ-PB3B2200V | 0.161 | 15 | 2.42
3 | 100K | Resistor | 603 | R34, R36, R40 | https://www.mouser.com/ProductDetail/Panasonic/ERJ-PB3B1003V | 0.161 | 15 | 2.415
1 | 40.2K | Resistor | 603 | R35 | https://www.mouser.com/ProductDetail/KOA-Speer/RK73H1JTTDD4022F | 0.015 | 10 | 0.15
2 | 4.7k | Resistor | 402 | R45, R46 | https://www.mouser.com/ProductDetail/Panasonic/ERA-2ARC472X | 0.103 | 10 | 1.03
1 | 124K | Resistor | 603 | R37 | https://www.mouser.com/ProductDetail/Bourns/CR0603-FX-1243ELF | 0.033 | 10 | 0.33
1 | Bicolor LED | R/G Bicoler LED |  | R/G LED | https://www.mouser.com/ProductDetail/Bivar/3BC-3-CA-F | 0.6 | 5 | 3
1 | 824501800 | TVS Diodes |  | D1 | https://www.mouser.com/ProductDetail/Wurth-Electronics/824501800 | 0.28 | 5 | 1.4
1 | 1n4148 | 1N4148 diode |  | D2 | https://www.mouser.com/ProductDetail/Micro-Commercial-Components-MCC/1N4148WX-TP | 0.18 | 5 | 0.9
1 | DTA114YUAT106 | PNP Transistor |  | Q2 | https://www.mouser.com/ProductDetail/ROHM-Semiconductor/DTA114YUAT106?qs=sGAEpiMZZMvcRsgoMFfePxX1F5rEfXFV | 0.19 | 5 | 0.95
1 | MP1584 | IC BUCK CONVERTER |  | U$4 | https://www.mouser.com/ProductDetail/Monolithic-Power-Systems-MPS/MP1584EN-LF-Z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 | 2.94 | 5 | 14.7
1 | NA | mini pushbutton switch | NA | S100 | https://www.sparkfun.com/products/97 | 0.35 | 5 | 1.75
1 | NA | Blue 3mm LED |  | BLUELED | https://www.mouser.com/ProductDetail/Lumex/SSL-LX3054USBD
1 | DMC3400SSDW | MOSFET N/P-CH |  | U$1, U$2 | https://www.digikey.com/product-detail/en/diodes-incorporated/DMC3400SDW-7/DMC3400SDW-7DICT-ND/5223236 | 0.51 | 5 | 2.55
1 | SN74LVC1G3157 | Multiplexer |  | U1 | https://www.digikey.com/product-detail/en/texas-instruments/SN74LVC1G3157DBVR/296-14908-1-ND/562548 | 0.37 | 5 | 1.85
1 | ADE7953 | ENERGY METERING |  | U2 | https://www.digikey.com/product-detail/en/analog-devices-inc/ADE7953ACPZ-RL/ADE7953ACPZ-RLCT-ND/4885439 | 4.16 | 5 | 20.8
1 | ESP32 WROOM-02 | ESP32WROOM-02 |  | U3 | https://www.digikey.com/products/en?mpart=3320&v=1528 | 8.95 | 5 | 44.75
1 | MP1584 | IC BUCK CONVERTER |  | U$4 | https://www.digikey.com/product-detail/en/monolithic-power-systems-inc/MP1584EN-LF/MP1584EN-LF-ND/5291741 | 2.15 | 5 | 10.75
1 | 8 pin 2mm connector | 8 pin 2mm connector |  | U$3 | https://www.digikey.com/product-detail/en/molex-llc/0894000820/WM14853-ND/3264983 | 0.48 | 5 | 2.4
1 | 2mm connector 6 pins | 2mm connector 6-pins |  | U$5 | https://www.digikey.com/product-detail/en/molex-llc/0894000620/WM10120-ND/3264980 | 0.3 | 5 | 1.5
1 | B340A-13-F | schottky diode |  | D3 | https://www.digikey.com/product-detail/en/diodes-incorporated/B340A-13-F/B340A-FDICT-ND/725054 | 0.46 | 5 | 2.3
1 | Oscillator | 3.57MHz oscillator |  | Q1 | https://www.digikey.com/product-detail/en/txc-corporation/9C-3.579545MBBK-T/887-2450-1-ND/4475440 | 0.36 | 5 | 1.8
1 | 10-Pin Header | 10-Pin Header |  | J1 | https://www.digikey.com/product-detail/en/amphenol-fci/20021121-00010C4LF/609-3695-2-ND/2209057 | 0.45 | 5 | 2.25 | 235.5
1 | I2C header | 4-Pin Header 2mm |  | JP2 | https://www.mouser.com/ProductDetail/TE-Connectivity/440054-4

Sheet: Mouser
Smartenit Board BoM
Qty | Value | Device | Package | Parts | URL | Price per unit | Total quantity (5 boards) | Price (5 boards)
1 | 1 uF, 25V | Capacitor | 603 | C1 | https://www.mouser.com/ProductDetail/AVX/0603DC105MAT2A | 0.251 | 10 | 2.51
6 | 100 nF | Capacitor | 402 | C3, C5,C9, C10, C13, C16 | https://www.mouser.com/ProductDetail/Taiyo-Yuden/LMK105BJ104MC-F | 0.102 | 30 | 1.02
3 | 100nF | Capacitor | 603 | C21,C23, C25 | https://www.mouser.com/ProductDetail/AVX/MM035C104KCZ2A | 1.51 | 15 | 22.65
2 | 20 pF | Capacitor | 402 | C7, C8 | https://www.mouser.com/ProductDetail/KEMET/CBR04C200F2GAC | 0.554 | 10 | 5.54
2 | 10 uF Polarized | Capacitor | 805 | C2, C22 | https://www.mouser.com/ProductDetail/KEMET/T529P106M010AAE200 | 0.459 | 10 | 4.59
4 | 33 nF | Capacitor | 402 | C4, C14, C17, C18 | https://www.mouser.com/ProductDetail/KEMET/C0402C333K3RACAUTO | 0.133 | 20 | 2.66
2 | 33 nF | Capacitor | 805 | C19, C20 | https://www.mouser.com/ProductDetail/KEMET/C0805C333G8JACTU | 0.38 | 10 | 3.8
1 | 22uF/ 6.3V | Capacitor | 603 | C6 | https://www.mouser.com/ProductDetail/Murata-Electronics/GRT188R60J226ME13D | 0.36 | 10 | 3.6
3 | 4.7 uF | Capacitor | 402 | C11, C12, C15 | https://www.mouser.com/ProductDetail/AVX/0402ZD475KAT2A | 0.213 | 15 | 3.195
1 | 150 pF | Capacitor | 603 | C26 | https://www.mouser.com/ProductDetail/KEMET/C0603C151K5RACTU?qs=sGAEpiMZZMs0AnBnWHyRQCTbZkhRx37bxzObmzsa0pg%3d | 0.122 | 10 | 1.22
1 | 100 uF polarized | Capacitor | PTH | C24 | https://www.mouser.com/ProductDetail/Nichicon/URS1E101MDD?qs=sGAEpiMZZMtZ1n0r9vR22Xsgo43SDd6qbF6qX3qWQWE%3d | 0.195 | 10 | 1.95
5 | 10K | Resistor | 603 | R1, R10, R11, R38,R39 | https://www.mouser.com/ProductDetail/Vishay-BC-Components/MCT0603PD1002DP500 | 0.434 | 25 | 10.85
1 | 10K | Resistor | 402 | R22, | https://www.mouser.com/ProductDetail/Vishay/CRCW040210K0FKEDC | 0.041 | 10 | 0.41
1 | 56K | Resistor | 603 | R2 | https://www.mouser.com/ProductDetail/Panasonic/ERJ-S03J563V | 0.23 | 10 | 2.3
1 | 200K | Resistor | 603 | R3 | https://www.mouser.com/ProductDetail/Panasonic/ERJ-P03F2003V?qs=sGAEpiMZZMvdGkrng054tzSGWtpoOZZIMsPP8ce52zM%3d | 0.231 | 10 | 2.31
3 | 1K | Resistor | 603 | R4, R8, R13, | https://www.mouser.com/ProductDetail/KOA-Speer/RK73G1JTTD1001C | 0.367 | 15 | 5.51
4 | 1K | Resistor | 402 | R17, R21, R24, R26 | https://www.mouser.com/ProductDetail/KOA-Speer/RK73G1ETTP1001C | 0.367 | 20 | 7.34
2 | 1K | Resistor | 805 | R23, R31 | https://www.mouser.com/ProductDetail/Vishay/RCS08051K00JNEA | 0.19 | 10 | 1.9
4 | 470 | Resistor | 402 | R5, R7, R14, R15 | https://www.mouser.com/ProductDetail/Panasonic/ERJ-PA2D4700X | 0.2 | 20 | 4
3 | 12K | Resistor | 402 | R6, R16, R32 | https://www.mouser.com/ProductDetail/Panasonic/ERA-2AEB123X?qs=sGAEpiMZZMvdGkrng054t8sBRtayFjgRL6Dhtf0uAlQ%3d | 0.585 | 15 | 8.78
2 | 4.7K | Resistor | 603 | R9, R12, | https://www.mouser.com/ProductDetail/KOA-Speer/RK73G1JTTD4701C | 0.367 | 10 | 3.67
4 | 9.1K | Resistor | 402 | R18, R25, R27, R28 | https://www.mouser.com/ProductDetail/Panasonic/ERA-2AEB912X | 0.585 | 20 | 11.7
4 | 51 | Resistor | 402 | R19, R20, R29, R30 | https://www.mouser.com/ProductDetail/Panasonic/ERJ-PA2D51R0X | 0.2 | 20 | 4
3 | 220 | Resistor | 603 | R33, R41, R42 | https://www.mouser.com/ProductDetail/Panasonic/ERJ-PB3B2200V | 0.161 | 15 | 2.42
3 | 100K | Resistor | 603 | R34, R36, R40 | https://www.mouser.com/ProductDetail/Panasonic/ERJ-PB3B1003V | 0.161 | 15 | 2.415
1 | 40.2K | Resistor | 603 | R35 | https://www.mouser.com/ProductDetail/KOA-Speer/RK73H1JTTDD4022F | 0.015 | 10 | 0.15
2 | 4.7k | Resistor | 603 | R43, R44 | https://www.mouser.com/ProductDetail/ROHM-Semiconductor/ESR03EZPF4701 | 0.103 | 10 | 1.03
1 | 124K | Resistor | 603 | R37 | https://www.mouser.com/ProductDetail/Bourns/CR0603-FX-1243ELF | 0.033 | 10 | 0.33
1 | Bicolor LED | R/G Bicoler LED |  | R/G LED | https://www.mouser.com/ProductDetail/Bivar/3BC-3-CA-F | 0.6 | 5 | 3
1 | 824501800 | TVS Diodes |  | D1 | https://www.mouser.com/ProductDetail/Wurth-Electronics/824501800 | 0.28 | 5 | 1.4
1 | 1n4148 | 1N4148 diode |  | D2 | https://www.mouser.com/ProductDetail/Micro-Commercial-Components-MCC/1N4148WX-TP | 0.18 | 5 | 0.9
1 | DTA114YUAT106 | PNP Transistor |  | Q2 | https://www.mouser.com/ProductDetail/ROHM-Semiconductor/DTA114YUAT106?qs=sGAEpiMZZMvcRsgoMFfePxX1F5rEfXFV | 0.19 | 5 | 0.95
1 | MP1584 | IC BUCK CONVERTER |  | U$4 | https://www.mouser.com/ProductDetail/Monolithic-Power-Systems-MPS/MP1584EN-LF-Z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 | 2.94 | 5 | 14.7 | 142.8

Sheet: Digikey
Qty | Value | Device | Package | Parts | URL | Price per unit | Total quantity (5 boards) | Price (5 boards) | TOTAL
1 | DMC3400SSDW | MOSFET N/P-CH |  | U$1, U$2 | https://www.digikey.com/product-detail/en/diodes-incorporated/DMC3400SDW-7/DMC3400SDW-7DICT-ND/5223236 | 0.51 | 5 | 2.55
1 | SN74LVC1G3157 | Multiplexer |  | U1 | https://www.digikey.com/product-detail/en/texas-instruments/SN74LVC1G3157DBVR/296-14908-1-ND/562548 | 0.37 | 5 | 1.85
1 | ADE7953 | ENERGY METERING |  | U2 | https://www.digikey.com/product-detail/en/analog-devices-inc/ADE7953ACPZ-RL/ADE7953ACPZ-RLCT-ND/4885439 | 4.16 | 5 | 20.8
1 | ESP32 WROOM-02 | ESP32WROOM-02 |  | U3 | https://www.digikey.com/products/en?mpart=3320&v=1528 | 8.95 | 5 | 44.75
1 | 8 pin 2mm connector | 8 pin 2mm connector |  | U$3 | https://www.digikey.com/product-detail/en/molex-llc/0894000820/WM14853-ND/3264983 | 0.48 | 5 | 2.4
1 | 2mm connector 6 pins | 2mm connector 6-pins |  | U$5 | https://www.digikey.com/product-detail/en/molex-llc/0894000620/WM10120-ND/3264980 | 0.3 | 5 | 1.5
1 | B340A-13-F | schottky diode |  | D3 | https://www.digikey.com/product-detail/en/diodes-incorporated/B340A-13-F/B340A-FDICT-ND/725054 | 0.46 | 5 | 2.3
1 | Oscillator | 3.57MHz oscillator |  | Q1 | https://www.digikey.com/product-detail/en/txc-corporation/9C-3.579545MBBK-T/887-2450-1-ND/4475440 | 0.36 | 5 | 1.8
1 | 10-Pin Header | 10-Pin Header |  | J1 | https://www.digikey.com/product-detail/en/amphenol-fci/20021121-00010C4LF/609-3695-2-ND/2209057 | 0.45 | 5 | 2.25 | 80.2

Sheet: Sparkfun
Qty | Value | Device | Package | Parts | URL | Price per unit | Total quantity (5 boards) | Price (5 boards) | TOTAL
1 | NA | mini pushbutton switch | NA | S100 | https://www.sparkfun.com/products/97 | 0.35 | 5 | 1.75 | 1.75
