CalPlug/EVSE_Smart_Charger/2017-2018 Project/FPGA Design/PCB Design/Microsemi Board BOM.xlsx

Microsemi board BoM
Part Title | Part Use | URL Link | Quantity needed per board | Price per unit | Full total: | UnHighlighted total:
Enclosure Poly-carbonate | Device Enclosure Back plate | https://store.openevse.com/collections/accessories/products/custom-enclosure-poly-carbonate-standard | 1 | 49 | 952.26 | 582.29
HAMMOND 1554C2GY ENCLOSURE, DIN RAIL, POLYCARBONATE, GRAY | Device Enclosure Front plate | https://www.amazon.com/HAMMOND-1554C2GY-ENCLOSURE-RAIL-POLYCARBONATE/dp/B005T7G7QA | 1 | 12.29
Ground Block | AC/DC common ground | https://store.openevse.com/collections/accessories/products/ground-block | 1 | 7.5
Relay 40A - Packard C240C - UL | DC relay control AC charging | https://store.openevse.com/collections/accessories/products/packard-c240c-40a-contactor-208-240vac-coil-50-60hz | 2 | 11.99
Water resistant - 16mm push button | buttons | https://store.openevse.com/collections/accessories/products/water-resistant-led-ring-push-button | 1 | 9.5
uxcell 16mm Blue Ring LED 4 Terminal Momentary Push Button Switch 1NO DC 3-5V | buttons with LEDs (way cooler) | https://www.amazon.com/uxcell-Terminal-Momentary-Button-Switch/dp/B00NWFV42S | 3 | 7.5
Current Transformer GFCI with self test | GFCI and test coils in one | https://store.openevse.com/collections/accessories/products/gfci-current-transformer | 3 | 29.5
Current Measurement Transformer | coils for current measurement of wattmeter | https://store.openevse.com/collections/accessories/products/current-measurement-transformer-kit | 2 | 24.5
Cable Gland - Large | interface of cables to EVSE unit | https://store.openevse.com/collections/accessories/products/cable-gland-cg-17 | 2 | 9.5
J-PLUG - 40 Amp, J1772 EVSE cable (15ft) | EVSE charge cable | https://www.amazon.com/J-PLUG-J1772-EVSE-cable-15ft/dp/B01CLXEHWU?s=automotive | 1 | 129
ABN Welding Cable 20' Feet 8 AWG 40A with STW Jacket | AC plug for EVSE to wall | https://www.amazon.com/dp/B01MUA8M5W/ref=psdc_495312_t3_B06W563YSZ | 1 | 52.99
Advanced Series - 40A Kit Bundle | J1772 Plug/Holster/cable glands | https://store.openevse.com/products/ultimate-bundle-openevse-p50-wv-kit-level1-level2-50a-deluxe | 1 | 489
We found Kit Supplies and components needed for our design that we can use instead of buying the EVSE kit. These are found above in pink
Qty | Value | Device | Package | Parts | URL | Price per unit | Total quantity (5 boards) | Price (5 boards) | TOTAL
2 | TE 1776275-2 | M023.5MM_LOCK (M02) | SCREWTERMINAL-3.5MM-2_LOCK | AC_TEST, AC_LINE | https://www.sparkfun.com/products/8084 | 0.95 | 10 | 9.5
2 | Pilot | M03SCREW_LOCK (M03) | SCREWTERMINAL-3.5MM-3_LOCK.007S | PILOT, TO_DC_RELAY | https://www.sparkfun.com/products/8235 | 0.95 | 10 | 9.5
1 | P6SMB16A | DIODE-SMB (DIODE-) (Version 13) | SMB (Version 1) | TVS | https://www.digikey.com/product-detail/en/littelfuse-inc/P6SMB16A/P6SMB16ALFCT-ND/1766665?WT.srch=1 | 4.1 | 10 | 4.1
1 | 0.1uF | CAP0805 | 805 | C3 | https://www.digikey.com/product-detail/en/kemet/C0805C104K5RACTU/399-1170-1-ND/411445 | 0.56 | 10 | 0.56
6 | 1uF | CAP0805 | 805 | C2, C5, C6, C9, C10, C11 | https://www.digikey.com/product-detail/en/yageo/CC0805KKX7R7BB105/311-1365-1-ND/2103149 | 0.79 | 30 | 2.37
1 | 4.7uF | CAP0805 | 805 | C4 | https://www.digikey.com/product-detail/en/murata-electronics-north-america/GRM21BR61E475MA12L/490-5422-1-ND/2175229 | 1.17 | 10 | 1.17
1 | 2.2uF | CAP0805 | 805 | C7 | https://www.digikey.com/product-detail/en/taiyo-yuden/EMK212BJ225KG-T/587-1293-1-ND/931070 | 1.14 | 10 | 1.14
2 | 10uF | CAP-Polarized | EIA3216 | C1, C8 | https://www.digikey.com/product-detail/en/avx-corporation/F931A106MAA/478-8193-1-ND/4005560 | 0.248 | 10 | 2.48
1 | BAS40-06 | Schottky diode | SOT23 | D6 | https://www.digikey.com/product-detail/en/micro-commercial-co/BAS40-06-TP/BAS40-06TPMSCT-ND/717330 | 2.43 | 10 | 2.43
5 | 1N4148 | DIODE-SOD123 | SOD123 | D3, D4, D5, D7, D8 | https://www.digikey.com/product-detail/en/micro-commercial-co/1N4148W-TP/1N4148WTPMSCT-ND/717311 | 1.31 | 30 | 3.93
2 | 1N4004 | MBRA340T3G | SMD | D1, D2 | https://www.mouser.com/ProductDetail/ON-Semiconductor/MBRA340T3G/ | 0.42 | 10 | 4.7
1 | MPM-04E-1205 | MPM-04E-1205 | MPM-04E-1205 | DC1 | https://minmax.cdistore.com/ProductDetail/ABF04D125-MINMAX-POWER-INC/430770/ | 13.58 | 2 | 27.16
1 | NKE0305DC | NKE0305DC | 4SIL | DC3 | https://www.digikey.com/product-detail/en/murata-power-solutions-inc/NKE0305DC/811-1429-5-ND/1926990 | 37.85 | 5 | 189.25
1 | NMV1212SC | DCDC_SIP | DCDC_SIP | DC2 | https://www.digikey.com/product-detail/en/murata-power-solutions-inc/NMV1212SC/811-1601-5-ND/1927162 | 10.15 | 5 | 10.15
1 | ESP-01 | ESP-01 | ESP01 | ESP1 | https://www.digikey.com/product-detail/en/WRL-13678/1568-1235-ND/5725944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 | 6.95 | 10 | 69.5
3 | OMRON SWITCH | TL3305AF260QG tactile switch | BT4.5X4.5 | ESP_RST, FLASH, ROM_RST | https://www.mouser.com/ProductDetail/E-Switch/TL3305AF260QG/ | 0.182 | 25 | 4.55
2 | FTDI Header 6 | MO6LOCK | 1X06_LOCK | PROGRAM, CONNECT | https://www.digikey.com/product-detail/en/PRPC040SAAN-RC/S1011EC-40-ND/2775214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 | 5.92 | 10 | 5.92
2 | BEL1AFUSE | BEL1AFUSE | BEL1AFUSE1A | F1, F2 | https://www.digikey.com/product-detail/en/bel-fuse-inc/RST-1.6-BULK/507-1178-ND/809322 | 3.34 | 10 | 3.34
2 | Current Sensor Headers | M02LOCK | 1X02_LOCK | J1,J2 | IN CALPLUG!! | 0 | 0 | 0
1 | GFCI Header | M04LOCK | 1X04_LOCK | GFCI | IN CALPLUG!! | 0 | 0 | 0
2 | MID400 | MID400 | DIP08 | IC1, IC2 | https://www.digikey.com/product-detail/en/on-semiconductor/MID400/MID400-ND/31605 | 44.97 | 10 | 44.97
2 | LMV358 | LMV358 | SO08 | IC3, IC4 | https://www.digikey.com/product-detail/en/stmicroelectronics/LMV358IDT/497-4945-1-ND/1003416 | 4.25 | 10 | 4.25
1 | LED header | CONN_10" | 1X10 | LEDs | IN CALPLUG!! | 0 | 0 | 0
2 | 2222A |  | SOT23 | Q1, Q2 | https://www.digikey.com/product-detail/en/on-semiconductor/MMBT2222ALT1G/MMBT2222ALT1GOSCT-ND/1139806 | 0.106 | 10 | 1.06
6 | 10 | Resistor | 603 | R36, R37, R38, R39, R40, R44 | https://www.digikey.com/product-detail/en/vishay-beyschlag/MCT06030C1009FP500/MCT0603-10.0-CFCT-ND/2607880 | 0.22 | 30 | 0.66
1 | 33 |  | 603 | R46 | https://www.digikey.com/product-detail/en/yageo/RC0603JR-0733RL/311-33GRCT-ND/729718 | 0.11 | 10 | 0.11
4 | 75 |  | 603 | R35, R41, R42, R43 | https://www.digikey.com/product-detail/en/stackpole-electronics-inc/RNCP0603FTD75R0/RNCP0603FTD75R0CT-ND/2240423 | 0.03 | 20 | 0.6
3 | 100 |  | 603 | R12, R13, R14 | https://www.digikey.com/product-detail/en/yageo/RC0603FR-07100RL/311-100HRCT-ND/729835 | 0.15 | 20 | 0.3
1 | 180 |  | 1206 | R22 | https://www.digikey.com/product-detail/en/yageo/RC0603JR-07180RL/311-180GRCT-ND/729669 | 0.11 | 10 | 0.11
5 | 330 |  | 603 | R9, R15, R16, R24,R27 | https://www.digikey.com/product-detail/en/susumu/RR0816P-331-D/RR08P330DCT-ND/432712 | 0.11 | 20 | 0.21
1 | 649 |  | 603 | R21 | https://www.digikey.com/product-detail/en/te-connectivity-passive-product/RP73PF1J649RBTDF/A110090CT-ND/4034445 | 4.73 | 10 | 4.73
4 | 1k |  | 603 | R6, R8, R28, R33 | https://www.digikey.com/product-detail/en/vishay-beyschlag/MCT06030C1001FP500/MCT0603-1.00K-CFCT-ND/2607875 | 1.52 | 20 | 3.04
8 | 2k |  | 603 | R4, R29, R30, R31, R32, R34, R45, R47 | https://www.digikey.com/product-detail/en/vishay-beyschlag/MCT06030D2001BP500/749-1706-1-ND/7348014 | 4.91 | 40 | 19.64
2 | 2.4k |  | 603 | R18, R19 | https://www.digikey.com/product-detail/en/vishay-beyschlag/MCT06030C2401FP500/749-1623-1-ND/2607896 | 1.52 | 10 | 1.52
1 | 4.02k |  | 603 | R10 | https://www.digikey.com/product-detail/en/te-connectivity-passive-product/6-2176088-4/A110166CT-ND/4034521 | 4.73 | 10 | 4.73
3 | 10k |  | 603 | R3, R5, R26 | https://www.digikey.com/product-detail/en/vishay-beyschlag/MCT06030C1002FP500/MCT0603-10.0K-CFCT-ND/2607933 | 1.52 | 20 | 3.04
1 | 15k |  | 603 | R11 | https://www.digikey.com/product-detail/en/te-connectivity-passive-product/CRG0603F15K/A121558CT-ND/5246508 | 0.19 | 10 | 0.19
2 | 47k |  | AXIAL-0.4 | R1, R2 | https://www.digikey.com/product-detail/en/yageo/CFR-25JB-52-47K/47KQBK-ND/2218 | 0.6 | 10 | 0.6
2 | 50k |  | 805 | R17, R23 | https://www.digikey.com/product-detail/en/vishay-thin-film/PTN0805E5002BST1/764-1535-1-ND/7103319 | 6.47 | 10 | 6.47
1 | 100k |  | 805 | R7 | https://www.digikey.com/product-detail/en/yageo/RC0805FR-07100KL/311-100KCRCT-ND/730491 | 0.22 | 10 | 0.22
1 | 15k |  | 805 | R25 | https://www.digikey.com/product-detail/en/stackpole-electronics-inc/RMCF0805JT15K0/RMCF0805JT15K0CT-ND/1942578 | 0.17 | 10 | 0.17
1 | 40k (40.2k is used for 40k) |  | 805 | R20 | https://www.digikey.com/product-detail/en/vishay-beyschlag/MCT06030C4022FP500/749-1651-1-ND/7347959 | 1.52 | 10 | 1.52
1 | SF2 HEADER MALE (TALL) | CONN_10" | 1X10 | SF_HEAD_1 | http://www.king-cart.com/phoenixent/product=HEADERS+BREAKAWAY+.1SP+STR+SPECIAL+POST+LENGTHS/product_name=HWS3133 | 1.86 | 10 | 18.6
2 | SF2 HEADER MALE (TALL) | CONN_08" | 1X08 | SF_HEAD_2, SF_HEAD_4 | same as above
1 | SF2 HEADER MALE (TALL) | M06LOCK | 1X06_LOCK | SF2_HEAD_3 | same as above
1 | Buttons header | CONN_04 | 1X04 | BUTTONS | https://www.amazon.com/uxcell-Balance-Connector-Trumpet-Adapter/dp/B00UBWJ8MI?s=toys-and-games | 5.77 | 5 | 28.85
1 | 10k trimpot | 10k trimpot | PVG3G | POT1 | https://www.digikey.com/product-detail/en/bourns-inc/PVG3G103C01R00/490-6995-1-ND/3846192 | 13.86 | 10 | 13.86
1 | 2k trimpot | 2k trimpot | PVG3G | POT2 | https://www.digikey.com/product-detail/en/bourns-inc/PVG3G202C01R00/PVG3G202C01R00CT-ND/6613125 | 13.86 | 10 | 13.86
 |  |  |  |  | https://www.digikey.com/product-detail/en/on-semiconductor/MMBT2222ALT1G/MMBT2222ALT1GOSCT-ND/1139806 | 1.06 | 10 | 10.6
1 | Wattmeter Header | CONN_08" | 1X08 | WATTMETER | IN CALPLUG!! | 0 | 0 | 0
NOT NEEDED! | PRT-08432 | CONN_025MM (CONN_02) | SCREWTERMINAL-5MM-2 | VOLTAGE_READ | NOT NEEDED! | 0 | 0 | 0
NOT NEEDED! | CONN_022.54MM_SCREWTERM (CONN_02) | CONN_022.54MM_SCREWTERM (CONN_02) | 1X02_2.54_SCREWTERM | CURRENT_READ_1, CURREMT_READ_2 | NOT NEEDED! | 0 | 0 | 0
1 | 2X6 MALE | CONN_06X2PTH_FEMALE (CONN_06X2) | 2X6 | AUX_GPIO_HEADER | IN CALPLUG!! | 0 | 0 | 0
