CalPlug/EVSE_Smart_Charger/2016 Project/EVSE_DEMO_MATLAB_GUI/InOperation.PNG

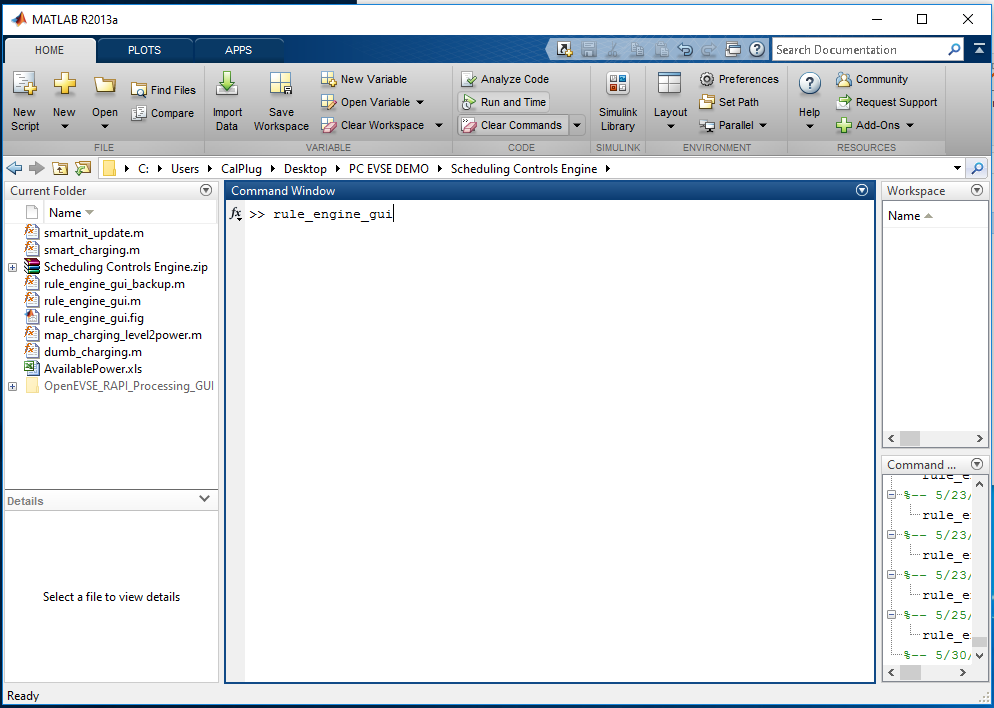
2016 Project/EVSE_DEMO_MATLAB_GUI/InOperation.PNG
