CalPlug/EVSE_Smart_Charger/EVSE code/Arduino/Documents/Current Sensor Calibration.xlsx

 | Current (A) | ChA (ADC Value) | ChB (ADC Value)
No Load | 0 | 8.87 | 27.23
Lights | 0.333 | 188332 | 35725
Lights+Heater | 1.955 | 1096320 | 206359
 | (constant current was 0.008A)
 | Forward
 | Backwards Regression
 | (calibration M and B values from here)
 | Backwards Regression |  | CHA - Gain | CHA - Offset | CHB - Gain | CHB - Offset
 |  |  | 0.0000017842 | -0.0013810688 | 0.0000094847 | -0.0027855398
