CalPlug/EVSE_Smart_Charger/EVSE code/Arduino/Documents/Current Sensor Calibration_Voltage_Current_PowerFactor.xlsx

Sheet: Current
Current Calibration - Read DAQ in each Current channel at 120.0V supply (L1) under different loads
Current Calibration
 | (constant current was 0.008A - subtracted from active loads)
 | Current (A) | ChA (ADC Value) | ChB (ADC Value)
No Load | 0 | 8.87 | 27.23
Lights | 0.333 | 188332 | 35725
Lights+Heater | 1.955 | 1096320 | 206359

Sheet: Voltage
Voltage Calibration - Read DAQ in each multiplexer state with Different Supply Voltages
Forward Polarity (Normal Polarity)
 |  | State A | State B
Measured Voltage | Measured Neutral Voltage | DAC_A | DAC_B
120.53 | 0.0597 | 1409447 | 3266145
90.45 | 0.0613 | 949988 | 2437335
128.62 | 0.0603 | 1539663 | 3491703
80.39 | 0.0572 | 817043 | 2157616
Reverse Polarity - Neutral and Line reversed
 |  | State A | State B
Measured Volt | Measured Neutral Volt | DAC_A | DAC_B
120.51 | 0.0581 | 3262058 | 1435104
135.36 | 0.0579 | 3686127 | 1623925
78.92 | 0.0591 | 2124861 | 775733
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
