CalPlug/EVSE_Smart_Charger/EVSE code/Arduino/Evaluation/ReadPilotdata_extended.xlsx

Sheet: Sheet1
requested current | state A | State B | state C | Estmated Tollerance
35 | 101 | 89 | 58 | 4
30 | 118 | 104 | 68 | 5
25 | 141 | 125 | 81 | 5
20 | 177 | 156 | 102 | 5
15 | 235 | 207 | 135 | 5
10 | 353 | 310 | 202 | 7
5 | 695 | 613 | 400 | 8
3 | 1169 | 1025 | 661 | 15

Sheet: DutyCycle Calculation
All |  | 06-051 |  | 051-80
Requested Current(A) | DutyCycle(%) | Requested Current(A) | DutyCycle(%) | Requested Current(A) | DutyCycle(%)
6 | 0.1 | 6 | 0.1 | 65 | 0.9
12 | 0.2 | 12 | 0.2 | 75 | 0.94
18 | 0.3 | 18 | 0.3 | 80 | 0.96
24 | 0.4 | 24 | 0.4
30 | 0.5 | 30 | 0.5
40 | 0.66 | 40 | 0.66
48 | 0.8 | 48 | 0.8
65 | 0.9
75 | 0.94
80 | 0.96
Transition Range
Requested Current(A) | DutyCycle(%)
40 | 0.66 | 0.719
48 | 0.8
65 | 0.9
