CalPlug/EVSE_Smart_Charger/(threads)

Thread 1 (2018-09-16):

wiring

Gior80, 2018-09-16:
hi,

can u explain me wiring schema for the esp32 version with 1 line??

- +/- 12 directly to power and this is ok
- rowgoski  coil on ipa/ipn
-  120V phase (DIRECTLY????) to VP??

Thread 2 (2020-11-04):

Hardware connections for the device

Ali-cr8, 2020-11-04:
Cant find a block diagram/ connections for the EVchargerESP32RTOS in read files.
In one of the circuit layout you have provided ,i could find ESP8266 instead of a ESP WROOM 32 which was mentioned in the read files ?.
If i am not mistaken ,this is designed for AC charging?

im trying to do a basic ev charger with iot  to monitor its details using esp wroom 32 ,thanks in advance.

Closed 2021-06-18.
