CalPlug/EVSE_Smart_Charger/2017-2018 Project/Smartenit PCB/Smartenit_Board_schematic.pdf

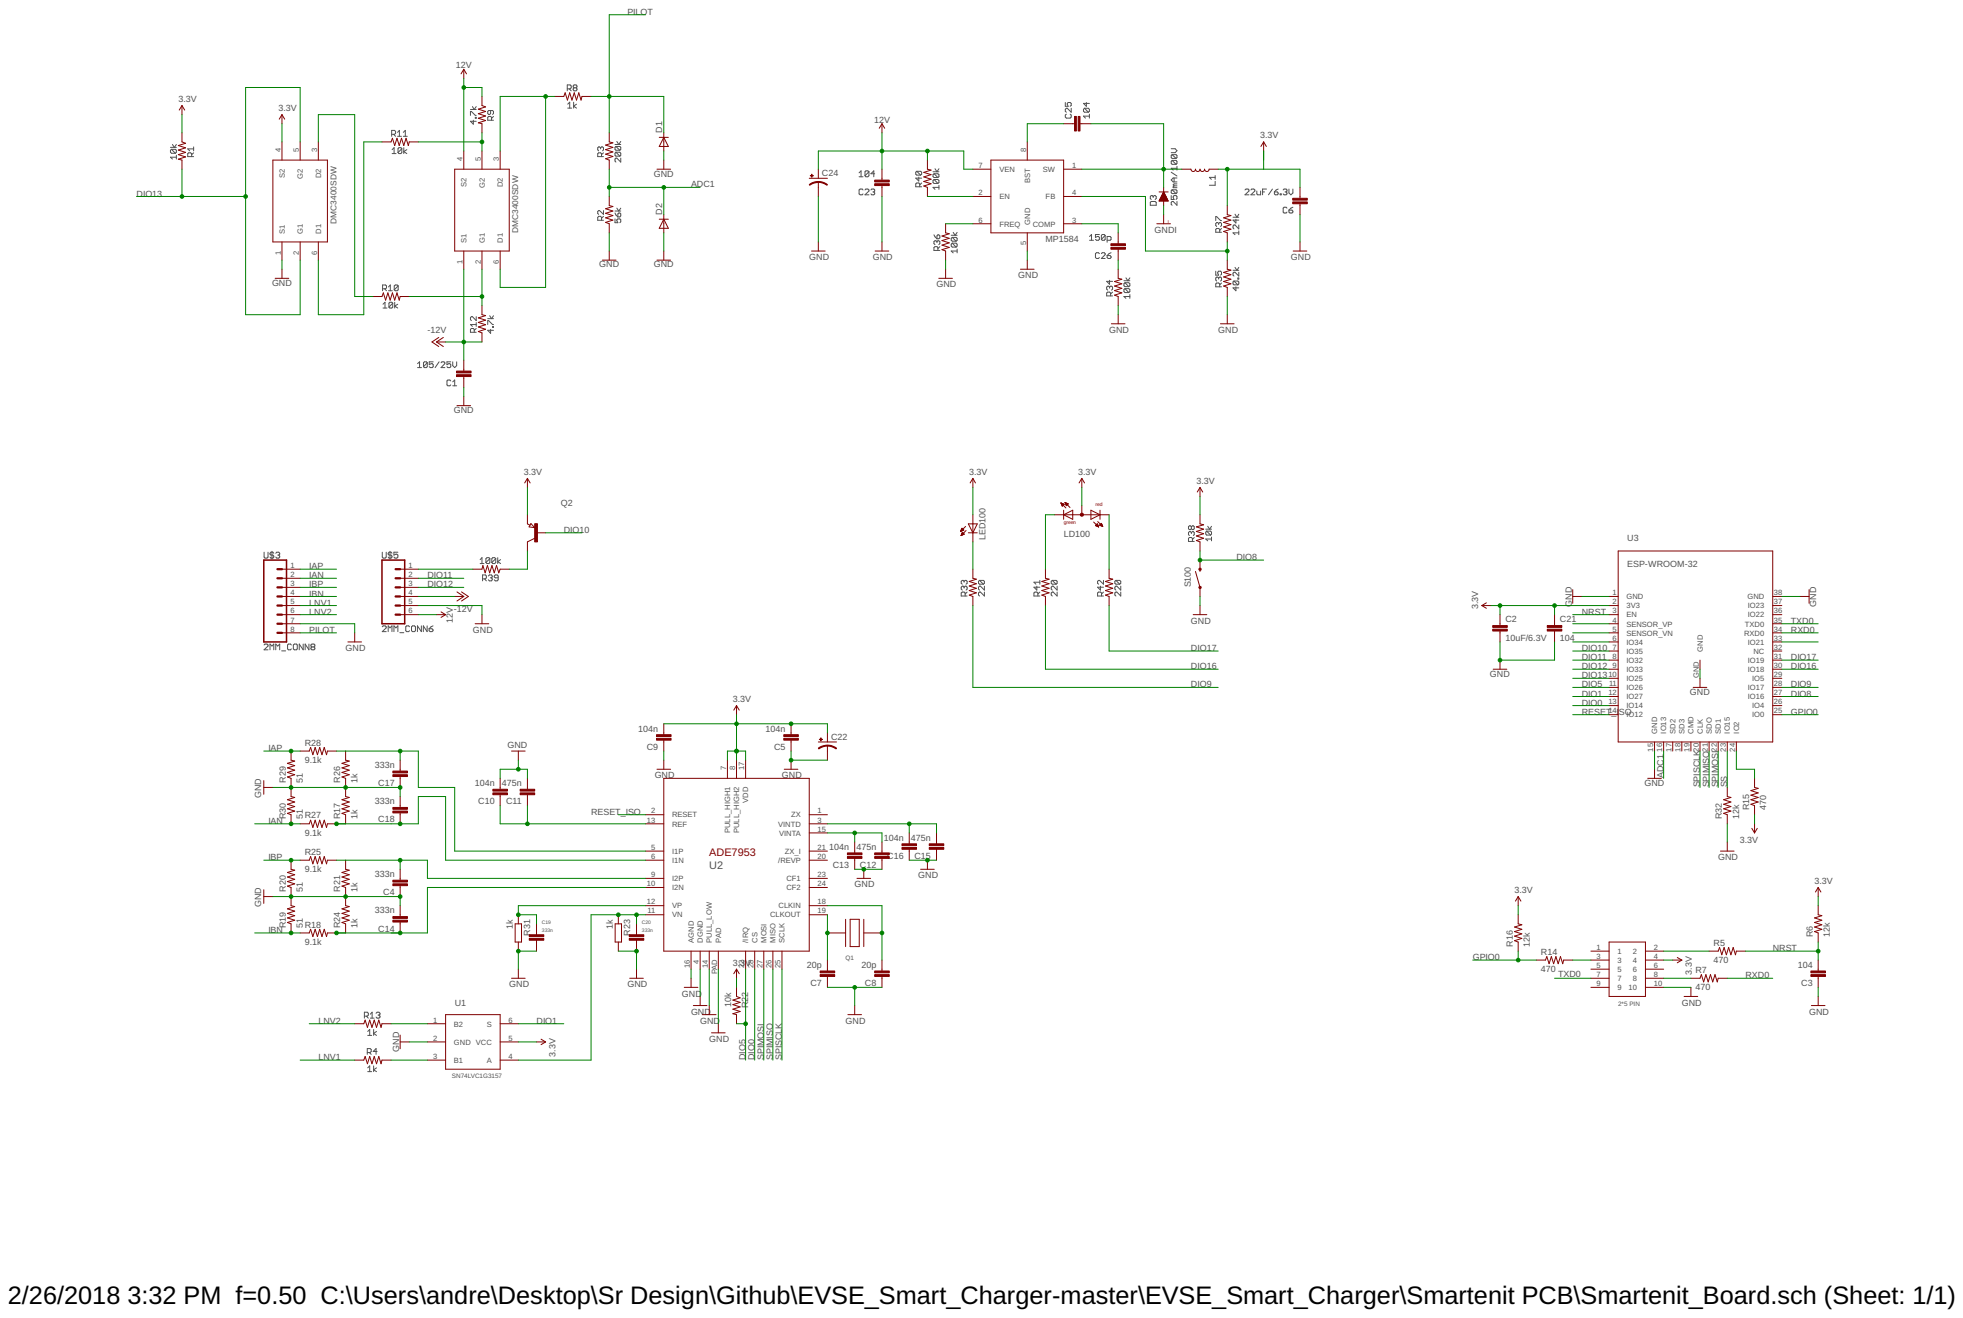
[picture p81: page 1]

2/26/2018 3:32 PM f=0.50 C:\Users\andre\Desktop\Sr Design\Github\EVSE_Smart_Charger-master\EVSE_Smart_Charger\Smartenit PCB\Smartenit_Board.sch (Sheet: 1/1)
