CalPlug/EVSE_Smart_Charger/2017-2018 Project/Zigbee Design/PCB Design/NXP_Smart_Charger.brd

## EAGLE design 2017-2018 Project/Zigbee Design/PCB Design/NXP_Smart_Charger.brd (2018-02-16)

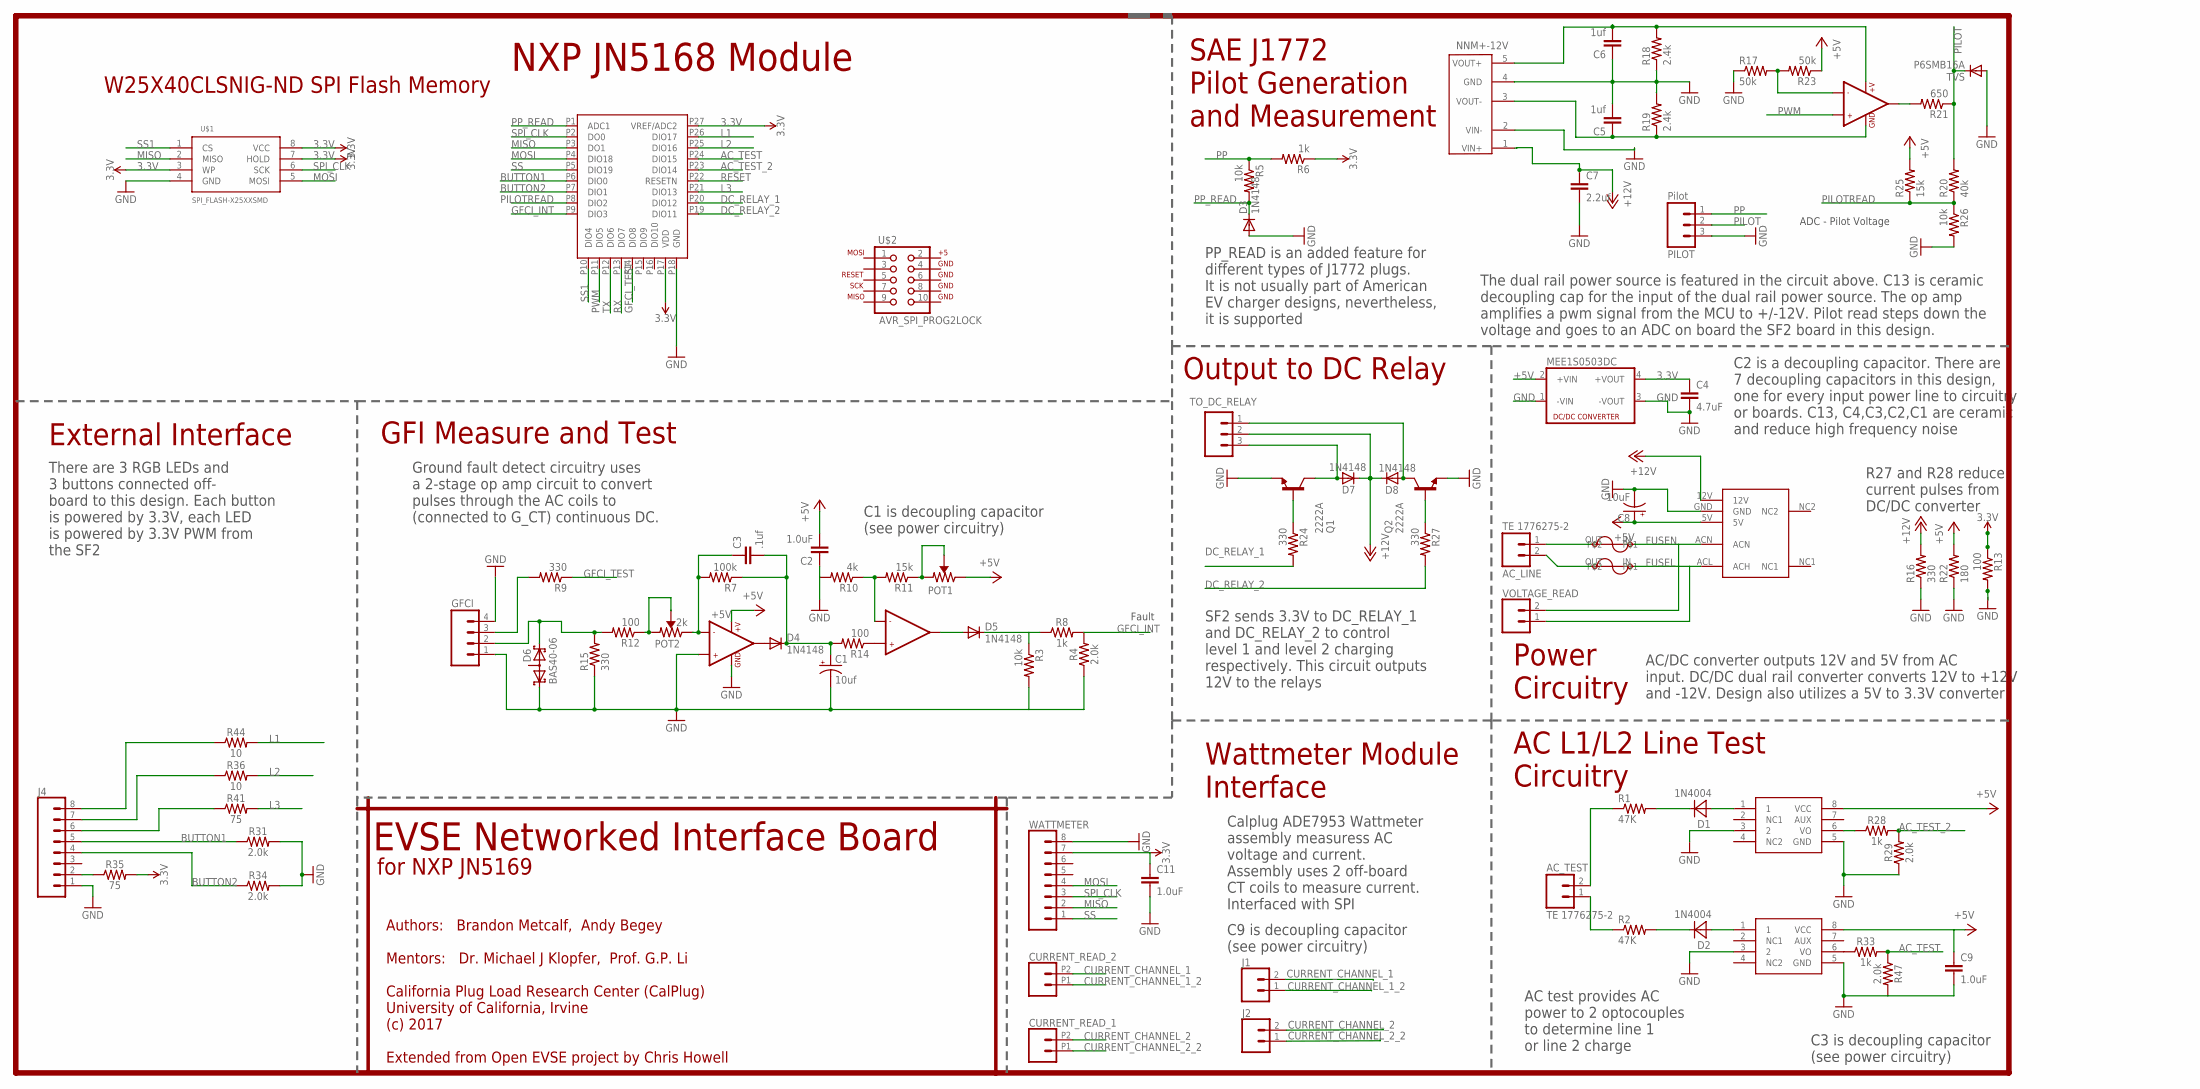
[picture p82: schematic NXP_Smart_Charger.sch]

Parts:
AC_LINE: TE 1776275-2; SCREWTERMINAL-3.5MM-2_LOCK
AC_TEST: TE 1776275-2; SCREWTERMINAL-3.5MM-2_LOCK
C1: 10uf; EIA3216
C2, C9, C11: 1.0uF; 0805
C3: .1uf; 0805
C4: 4.7uF; 0805
C5, C6: 1uf; 0805
C7: 2.2uf; 0805
C8: 10uF; EIA3216
CURRENT_READ_1, CURRENT_READ_2: CONN_022.54MM_SCREWTERM; 1X02_2.54_SCREWTERM
D1, D2: 1N4004; SMA
D3, D4, D5, D7, D8: 1N4148; SOD123
D6: BAS40-06; SOT23
DC1: MPM-04E-1205
DC2: NNM+-12V; DIP_5
F1, F2: BEL1AFUSE; BELFUSE1A
GFCI: M04LOCK; 1X04_LOCK
IC1, IC2: MID400; DIP08
IC3, IC4: LMV358; SO08
J1, J2: CONN_02; 1X02
J4: CONN_08"; 1X08
JN5168: NXP_JN5168-001-MO3; MODULE
MEE1S0503DC: NKE0305DC; 4SIL
PILOT: Pilot; SCREWTERMINAL-3.5MM-3_LOCK.007S
POT1: 10k; PV3G
POT2: 2k; PV3G
Q1, Q2: 2222A; SOT23
R1, R2: 47K; AXIAL-0.4
R3, R5, R26: 10k; 0603-RES
R4, R29, R31, R34, R47: 2.0k; 0603
R6: 1k; 0603-RES
R7: 100k; 0805
R8, R28, R33: 1k; 0603
R9, R15, R24: 330; 0603-RES
R10: 4k; 0603-RES
R11, R25: 15k; 0603-RES
R12, R13, R14: 100; 0603-RES
R16: 330; R0603
R17, R23: 50k; 0805
R18, R19: 2.4k; 0603-RES
R20: 40k; 0603-RES
R21: 650; 0603-RES
R22: 180; R0603
R27: 330; 0805
R35, R41: 75; 0603
R36, R44: 10; 0603
TO_DC_RELAY: M03SCREW_LOCK; SCREWTERMINAL-3.5MM-3_LOCK.007S
TVS: P6SMB16A; SMB
U$1: SPI_FLASH-X25XXSMD; SO08
U$2: AVR_SPI_PROG2LOCK; 2X5-SHROUDED_LOCK
VOLTAGE_READ: CONN_025MM; SCREWTERMINAL-5MM-2
WATTMETER: CONN_08"; 1X08

Connections:
3.3V: C4.1, C11.1, JN5168.P17 (VDD), JN5168.P27 (VREF/ADC2), MEE1S0503DC.4 (+VOUT), R6.1, R13.1, R35.2, U$1.3 (WP), WATTMETER.7
12V: C6.2, DC2.5 (VOUT+), IC4.8 (+V), R18.2
+5V: C2.2, C8.+, C9.1, DC1.5V, IC1.8 (VCC), IC2.8 (VCC), IC3.8 (+V), MEE1S0503DC.2 (+VIN), POT1.P$3 (CW), R22.2, R23.1, R25.2
+12V: C7.1, D7.C, D8.C, DC1.12V, DC2.1 (VIN+), R16.2, TO_DC_RELAY.2
-12V: C5.1, DC2.3 (VOUT-), IC4.4 (GND), R19.1
AC_TEST: JN5168.P24 (DIO15), R33.2, R47.1
AC_TEST_2: JN5168.P23 (DIO14), R28.2, R29.2
BUTTON1: J4.5, JN5168.P6 (DIO0), R31.1
BUTTON2: J4.4, JN5168.P7 (DIO1), R34.1
CURRENT_CHANNEL_1: CURRENT_READ_2.P2 (2), J1.2
CURRENT_CHANNEL_1_2: CURRENT_READ_2.P1 (1), J1.1
CURRENT_CHANNEL_2: CURRENT_READ_1.P2 (2), J2.2
CURRENT_CHANNEL_2_2: CURRENT_READ_1.P1 (1), J2.1
DC_RELAY_1: JN5168.P20 (DIO12), R24.2
DC_RELAY_2: JN5168.P19 (DIO11), R27.2
FUSEL: DC1.ACL (ACH), F2.IN, VOLTAGE_READ.1
FUSEN: DC1.ACN, F1.IN, VOLTAGE_READ.2
GFCI_INT: JN5168.P9 (DIO3), R4.2, R8.2
GFCI_TEST: JN5168.P14 (DIO8), R9.1
GND: C1.C (-), C2.1, C4.2, C5.2, C6.1, C7.2, C8.-, C9.2, C11.2, D3.A, D6.1 (K1), DC1.GND, DC2.2 (VIN-), DC2.4 (GND), GFCI.1, GFCI.4, IC1.3 (2), IC1.5 (GND), IC2.3 (2), IC2.5 (GND), IC3.3 (+IN1), IC3.4 (GND), J4.1, JN5168.P18 (GND), MEE1S0503DC.1 (-VIN), MEE1S0503DC.3 (-VOUT), PILOT.3, Q1.2 (E), Q2.2 (E), R3.2, R4.1, R10.2, R13.2, R15.1, R16.1, R17.1, R18.1, R19.2, R22.1, R26.2, R29.1, R31.2, R34.2, R47.2, TVS.A, U$1.4 (GND)
L1: JN5168.P26 (DIO17), R44.2
L2: JN5168.P25 (DIO16), R36.2
L3: JN5168.P21 (DIO13), R41.2
MISO: JN5168.P3 (DO1), U$1.2 (MISO), WATTMETER.2
MOSI: JN5168.P4 (DIO18), WATTMETER.4
unnamed: D8.A, Q2.3 (C), TO_DC_RELAY.1
unnamed: Q2.1 (B), R27.1
unnamed: IC2.6 (VO), R28.1
unnamed: D5.C, R3.1, R8.1
unnamed: POT2.P$1 (CCW), POT2.P$2 (WIPER), R12.1
unnamed: D7.A, Q1.3 (C), TO_DC_RELAY.3
unnamed: POT1.P$1 (CCW), POT1.P$2 (WIPER), R11.1
unnamed: C3.1, IC3.2 (-IN1), POT2.P$3 (CW), R7.2
unnamed: D1.C, R1.P$2 (2)
unnamed: IC4.2 (-IN1), R17.2, R23.2
unnamed: IC4.1 (OUT1), R21.2
unnamed: AC_LINE.2, F2.OUT
unnamed: AC_LINE.1, F1.OUT
unnamed: J4.8, R44.1
unnamed: J4.7, R36.1
unnamed: J4.6, R41.1
unnamed: AC_TEST.2, R1.P$1 (1)
unnamed: D1.A, IC2.1
unnamed: D6.2 (K2), GFCI.2, R12.2, R15.2
unnamed: D4.A, IC3.1 (OUT1)
unnamed: GFCI.3, R9.2
unnamed: C1.A (+), C3.2, D4.C, R7.1, R14.2
unnamed: IC3.6 (-IN2), R10.1, R11.2
unnamed: D5.A, IC3.7 (OUT2)
unnamed: IC3.5 (+IN2), R14.1
unnamed: D2.C, R2.P$2 (2)
unnamed: D2.A, IC1.1
unnamed: AC_TEST.1, R2.P$1 (1)
unnamed: Q1.1 (B), R24.1
unnamed: IC1.6 (VO), R33.1
unnamed: J4.2, R35.1
NC3: WATTMETER.8
PILOT: PILOT.2, R20.2, R21.1, TVS.C
PILOTREAD: JN5168.P8 (DIO2), R20.1, R25.1, R26.1
PP: PILOT.1, R5.1, R6.2
PP_READ: D3.C, JN5168.P1 (ADC1), R5.2
PWM: IC4.3 (+IN1), JN5168.P11 (DIO5)
RESET: JN5168.P22 (RESETN)
RX: JN5168.P13 (DIO7)
SPI_CLK: JN5168.P2 (DO0), WATTMETER.3
SS: JN5168.P5 (DIO19), WATTMETER.1
SS1: JN5168.P10 (DIO4), U$1.1 (CS)
TX: JN5168.P12 (DIO6)

Notes on the sheet:
SAE J1772 Pilot Generation and Measurement
ADC - Pilot Voltage
Fault
Ground fault detect circuitry uses a 2-stage op amp circuit to convert pulses through the AC coils to (connected to G_CT) continuous DC.
External Interface
GFI Measure and Test
Wattmeter Module Interface
Output to DC Relay
Power Circuitry
AC L1/L2 Line Test Circuitry
C1 is decoupling capacitor (see power circuitry)
There are 3 RGB LEDs and 3 buttons connected off- board to this design. Each button is powered by 3.3V, each LED is powered by 3.3V PWM from the SF2
Calplug ADE7953 Wattmeter assembly measuress AC voltage and current. Assembly uses 2 off-board CT coils to measure current. Interfaced with SPI
C9 is decoupling capacitor (see power circuitry)
C3 is decoupling capacitor (see power circuitry)
AC test provides AC power to 2 optocouples to determine line 1 or line 2 charge
C2 is a decoupling capacitor. There are 7 decoupling capacitors in this design, one for every input power line to circuitry or boards. C13, C4,C3,C2,C1 are ceramic and reduce high frequency noise
R27 and R28 reduce current pulses from DC/DC converter
AC/DC converter outputs 12V and 5V from AC input. DC/DC dual rail converter converts 12V to +12V and -12V. Design also utilizes a 5V to 3.3V converter
PP_READ is an added feature for different types of J1772 plugs. It is not usually part of American EV charger designs, nevertheless, it is supported
The dual rail power source is featured in the circuit above. C13 is ceramic decoupling cap for the input of the dual rail power source. The op amp amplifies a pwm signal from the MCU to +/-12V. Pilot read steps down the voltage and goes to an ADC on board the SF2 board in this design.
SF2 sends 3.3V to DC_RELAY_1 and DC_RELAY_2 to control level 1 and level 2 charging respectively. This circuit outputs 12V to the relays
EVSE Networked Interface Board
Authors: Brandon Metcalf, Andy Begey Mentors: Dr. Michael J Klopfer, Prof. G.P. Li California Plug Load Research Center (CalPlug) University of California, Irvine (c) 2017 Extended from Open EVSE project by Chris Howell
for NXP JN5169
NXP JN5168 Module
W25X40CLSNIG-ND SPI Flash Memory

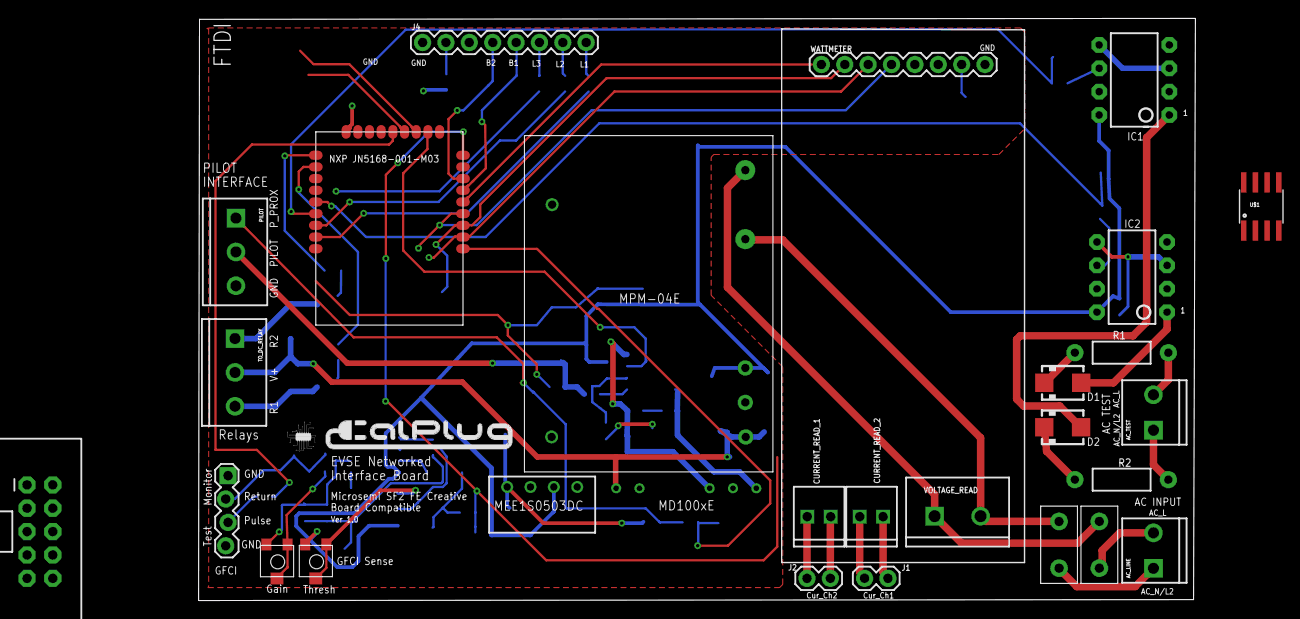
[picture p83: board NXP_Smart_Charger.brd from above]

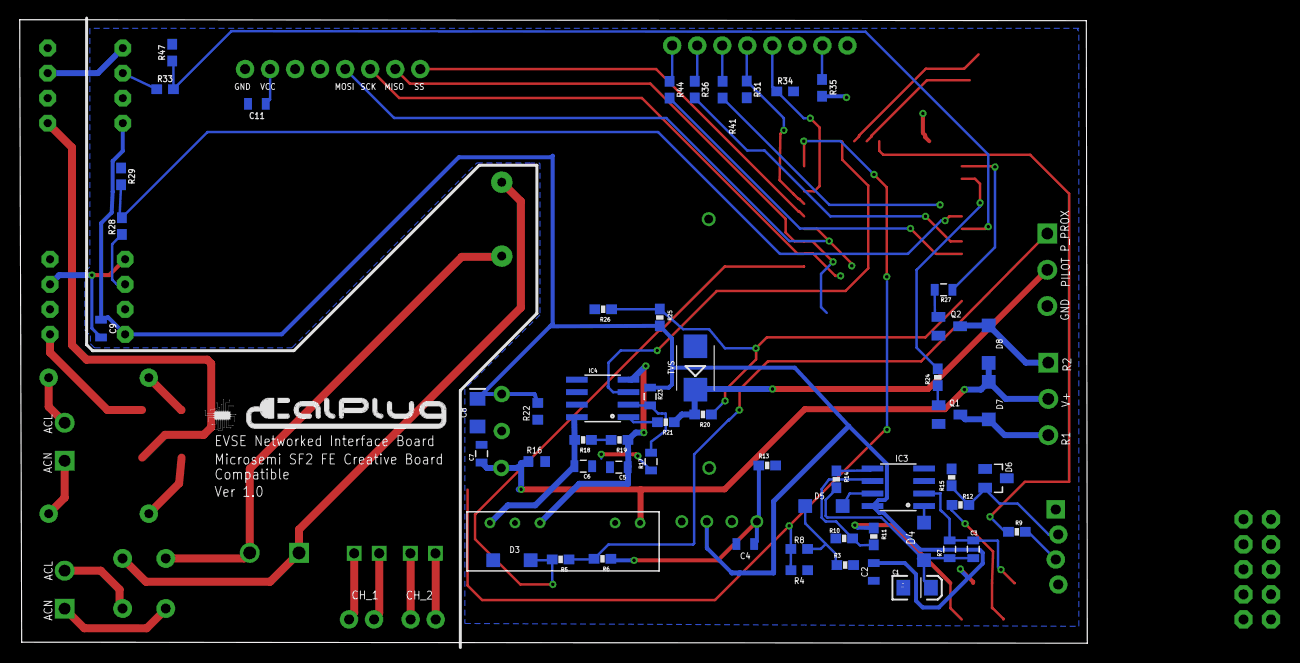
[picture p84: board NXP_Smart_Charger.brd from below]

Board: 2 copper layers, 108.3 x 63.3 mm, 84 parts (57 on the bottom side), 64 nets.
