CalPlug/EVSE_Smart_Charger/2017-2018 Project/Smartenit PCB/Smartenit_Board.brd

## EAGLE design 2017-2018 Project/Smartenit PCB/Smartenit_Board.brd (2018-05-16)

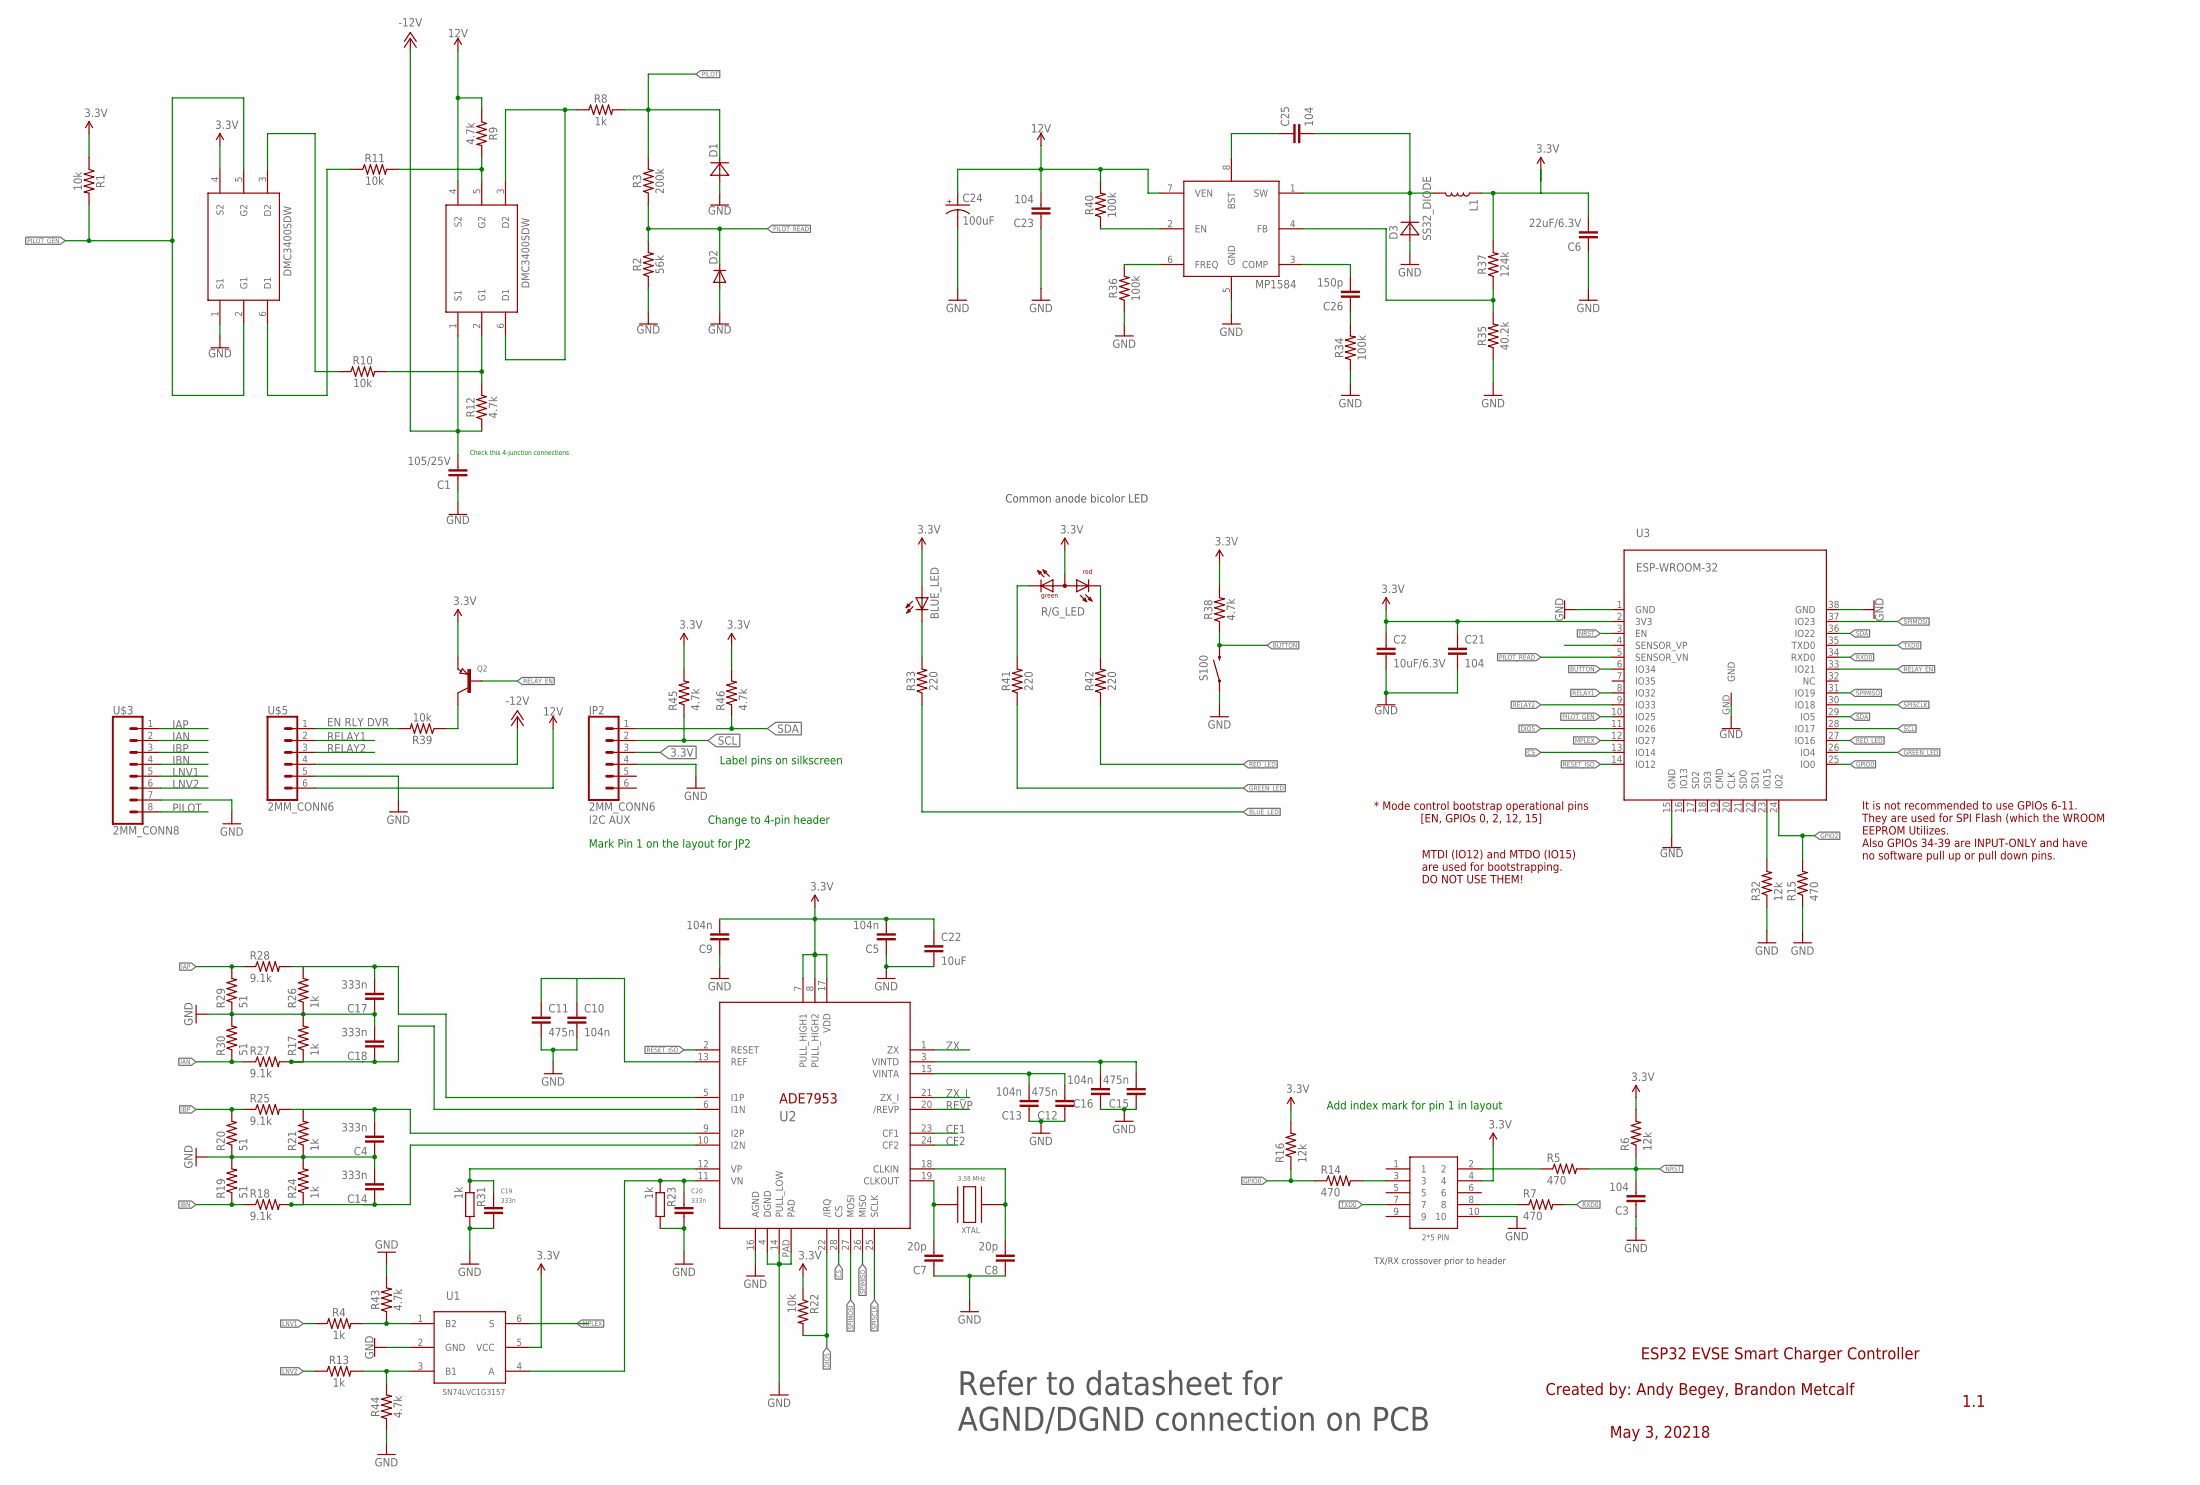
[picture p85: schematic Smartenit_Board.sch]

Parts:
BLUE_LED: LED3MM
C1: 105/25V; 0603
C2: 10uF/6.3V; 0805
C3: 104; 0402-CAP
C4, C14, C17, C18: 333n; 0402-CAP
C5, C9, C10, C13, C16: 104n; 0402-CAP
C6: 22uF/6.3V; 0603
C7, C8: 20p; 0402-CAP
C11, C12, C15: 475n; 0402-CAP
C19, C20: 333n; C0805K
C21: 104; 0603-CAP
C22: 10uF; 0805
C23, C25: 104; 0603
C24: 100uF; CPOL-RADIAL-100UF-25V
C26: 150p; 0603
D1: P6SMB16A; D014AC
D2: DIODESOD; SOD-323
D3: SS32_DIODE; D0-214AB
J1: 2X5CONNECTOR1.27MM; 1296-10
JP2: 2MM_CONN6; CONN6_2MM
L1: 47µH/±30%/750mA; CR54
Q2: PNP-TRANSISTOR_SOT23; SOT23
R1, R10, R11, R39: 10k; 0603
R2: 56k; 0603
R3: 200k; 0603
R4, R8, R13: 1k; 0603
R5, R7, R14, R15: 470; 0402-RES
R6, R16, R32: 12k; 0402-RES
R9, R12, R38, R43, R44: 4.7k; 0603
R17, R21, R24, R26: 1k; 0402-RES
R18, R25, R27, R28: 9.1k; 0402-RES
R19, R20, R29, R30: 51; 0402-RES
R22: 10k; 0402-RES
R23, R31: 1k; C0805K@1
R33, R41, R42: 220; 0603
R34, R36, R40: 100k; 0603
R35: 40.2k; 0603
R37: 124k; 0603
R45, R46: 4.7k; 0402-RES
R/G_LED: DUOLED-RG-A; DUOLED-A-5MM
S100: SWITCH-MOMENTARY-2PTH; TACTILE-PTH
U1: SN74LVC1G3157; DBV-6
U2: ADE7953; 28-WFQFN
U3: ESP-WROOM-32
U$1, U$2: DMC3400SSDW; SOT363
U$3: 2MM_CONN8; CONN82MM
U$4: MP1584; SOIC8
U$5: 2MM_CONN6; CONN6_2MM
XTAL: QUARTZ_3.58M_2PIN; HC-49S

Connections:
3.3V: BLUE_LED.A, C2.1, C5.2, C6.2, C9.2, C21.1, C22.1, J1.4, JP2.3 (PIN3), L1.P$1 (1), Q2.2 (E), R1.1, R6.2, R16.2, R22.1, R37.2, R38.2, R45.2, R46.2, R/G_LED.A, U1.5 (VCC), U2.7 (PULL_HIGH1), U2.8 (PULL_HIGH2), U2.17 (VDD), U3.2 (3V3), U$1.4 (S2)
12V: C23.2, C24.1 (+), R9.1, R40.2, U$2.4 (S2), U$4.7 (VEN), U$5.6 (PIN6)
-12V: C1.2, R12.1, U$2.1 (S1), U$5.4 (PIN4)
AGND: C4.1, C10.2, C11.2, C12.1, C13.1, C14.2, C17.1, C18.2, C19.2, C20.2, R17.2, R19.2, R20.1, R21.1, R23.2, R24.2, R26.1, R29.1, R30.2, R31.2, U1.2 (GND), U2.16 (AGND), U$3.7
BLUE_LED: R33.1
BUTTON: R38.1, S100.3 (2), U3.6 (IO34)
CF1: U2.23 (CF1)
CF2: U2.24 (CF2)
CS: U2.28 (CS), U3.13 (IO14)
DGND: C1.1, C2.2, C3.1, C5.1, C6.1, C7.1, C8.1, C9.1, C15.1, C16.1, C21.2, C22.2, C23.1, C24.2 (-), D1.P, D2.2 (A), J1.10, R2.1, R15.1, R32.1, R34.1, R35.1, R36.1, R43.2, R44.1, S100.1, U2.4 (DGND), U2.14 (PULL_LOW), U2.PAD, U3.1 (GND), U3.15 (GND), U3.38 (GND), U3.GND, U$1.1 (S1), U$4.5 (GND), U$5.5 (PIN5)
DIO5: R22.2, U2.22 (/IRQ), U3.11 (IO26)
FRGGN: R32.2, U3.23 (IO15)
GND: D3.P, JP2.4 (PIN4)
GPIO0: R14.1, R16.1, U3.25 (IO0)
GPIO2: R15.2, U3.24 (IO2)
GREEN_LED: R41.1, U3.26 (IO4)
IAN: R27.1, R30.1, U$3.2
IAP: R28.1, R29.2, U$3.1
IBN: R18.1, R19.1, U$3.4
IBP: R20.2, R25.1, U$3.3
LNV1: R4.1, U$3.5
LNV2: R13.1, U$3.6
MPLEX: U1.6 (S), U3.12 (IO27)
unnamed: C7.2, U2.19 (CLKOUT), XTAL.1
unnamed: C8.2, U2.18 (CLKIN), XTAL.2
unnamed: C20.1, R23.1, U1.4 (A), U2.11 (VN)
unnamed: R36.2, U$4.6 (FREQ)
unnamed: C4.2, R21.2, R25.2, U2.9 (I2P)
unnamed: C10.1, C11.1, U2.13 (REF)
unnamed: C12.2, C13.2, U2.15 (VINTA)
unnamed: R4.2, R43.1, U1.1 (B2)
unnamed: C14.1, R18.2, R24.1, U2.10 (I2N)
unnamed: C15.2, C16.2, U2.3 (VINTD)
unnamed: R13.2, R44.2, U1.3 (B1)
unnamed: R40.1, U$4.2 (EN)
unnamed: C26.2, U$4.3 (COMP)
unnamed: C26.1, R34.2
unnamed: C25.2, D3.N, L1.P$2 (2), U$4.1 (SW)
unnamed: R35.2, R37.1, U$4.4 (FB)
unnamed: Q2.3 (C), R39.1
unnamed: BLUE_LED.K (C), R33.2
unnamed: C25.1, U$4.8 (BST)
unnamed: R9.2, R11.2, U$2.5 (G2)
unnamed: C17.2, R26.2, R28.2, U2.5 (I1P)
unnamed: R41.2, R/G_LED.CX (CG)
unnamed: R42.2, R/G_LED.CR
unnamed: C18.1, R17.1, R27.2, U2.6 (I1N)
unnamed: R10.1, U$1.3 (D2)
unnamed: R10.2, R12.2, U$2.2 (G1)
unnamed: R11.1, U$1.6 (D1)
unnamed: R8.1, U$2.3 (D2), U$2.6 (D1)
unnamed: R39.2, U$5.1 (PIN1)
unnamed: J1.3, R14.2
unnamed: J1.2, R5.1
unnamed: J1.8, R7.1
NRST: C3.2, R5.2, R6.1, U3.3 (EN)
PILOT: D1.N, R3.2, R8.2, U$3.8
PILOT_GEN: R1.2, U3.10 (IO25), U$1.2 (G1), U$1.5 (G2)
PILOT_READ: D2.1 (C), R2.2, R3.1, U3.5 (SENSOR_VN)
RED_LED: R42.1, U3.27 (IO16)
RELAY1: U3.8 (IO32), U$5.2 (PIN2)
RELAY2: U3.9 (IO33), U$5.3 (PIN3)
RELAY_EN: Q2.1 (B), U3.33 (IO21)
RESET_ISO: U2.2 (RESET), U3.14 (IO12)
REVP: U2.20 (/REVP)
RXD0: R7.2, U3.34 (RXD0)
SCL: JP2.2 (PIN2), R45.1, U3.28 (IO17)
SDA: JP2.1 (PIN1), R46.1, U3.29 (IO5), U3.36 (IO22)
SPIMISO: U2.26 (MISO), U3.31 (IO19)
SPIMOSI: U2.27 (MOSI), U3.37 (IO23)
SPISCLK: U2.25 (SCLK), U3.30 (IO18)
TXD0: J1.7, U3.35 (TXD0)
V2P: C19.1, R31.1, U2.12 (VP)
ZX: U2.1 (ZX)
ZX_I: U2.21 (ZX_I)

Notes on the sheet:
* Mode control bootstrap operational pins [EN, GPIOs 0, 2, 12, 15]
MTDI (IO12) and MTDO (IO15) are used for bootstrapping. DO NOT USE THEM!
It is not recommended to use GPIOs 6-11. They are used for SPI Flash (which the WROOM EEPROM Utilizes. Also GPIOs 34-39 are INPUT-ONLY and have no software pull up or pull down pins.
I2C AUX
Mark Pin 1 on the layout for JP2
Label pins on silkscreen
Change to 4-pin header
Add index mark for pin 1 in layout
Common anode bicolor LED
Refer to datasheet for AGND/DGND connection on PCB
EN RLY DVR
3.58 MHz
ESP32 EVSE Smart Charger Controller
1.1
Created by: Andy Begey, Brandon Metcalf
May 3, 20218
Check this 4-junction connections
TX/RX crossover prior to header

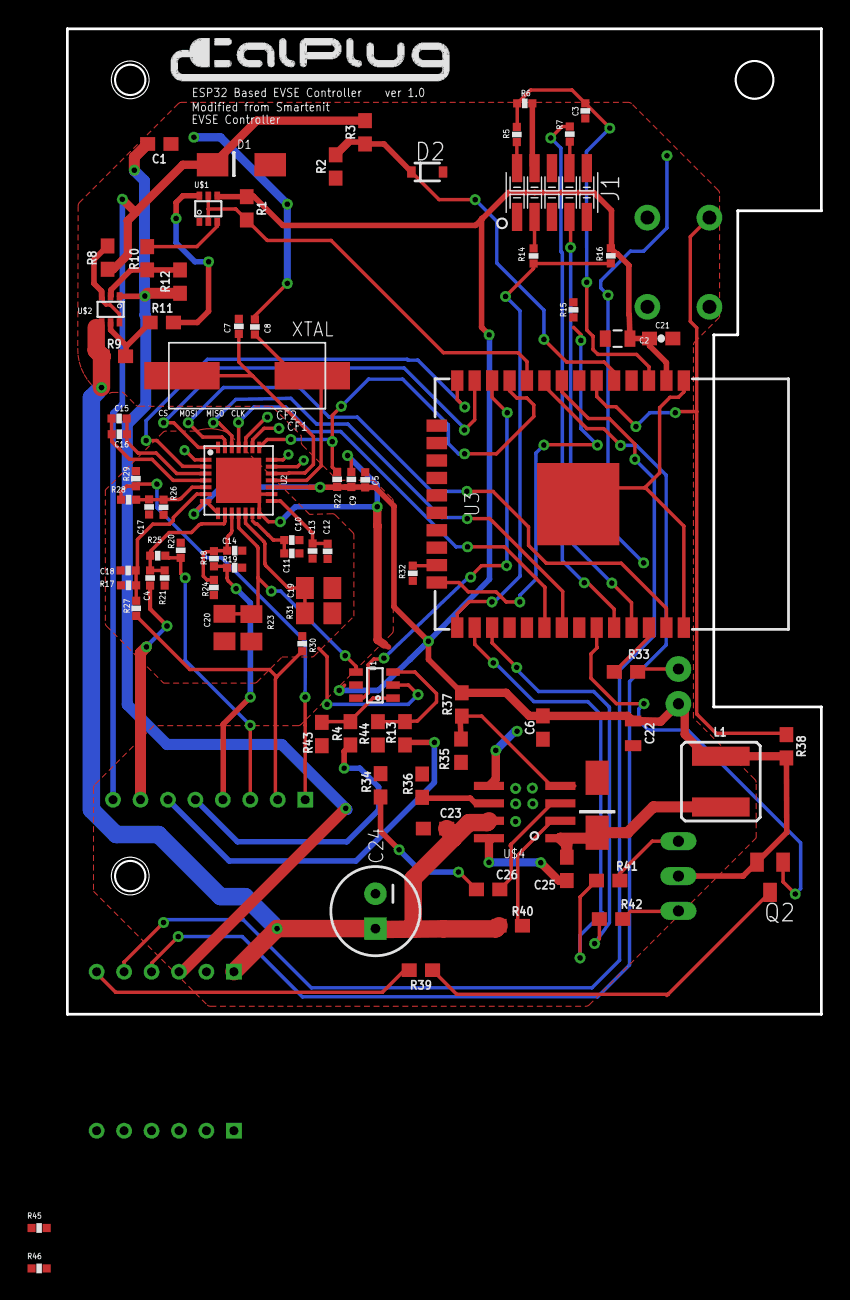
[picture p86: board Smartenit_Board.brd from above]

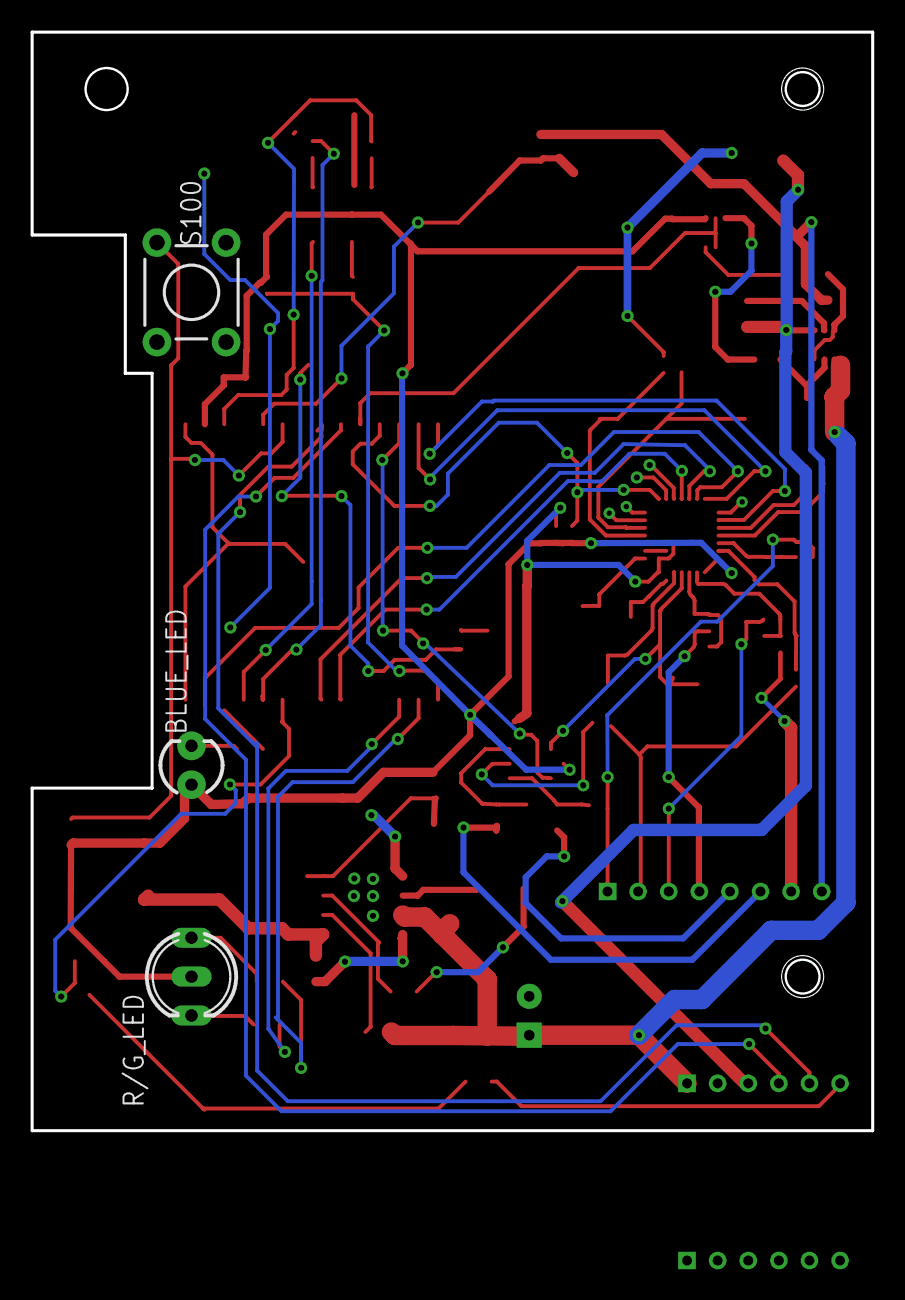
[picture p87: board Smartenit_Board.brd from below]

Board: 2 copper layers, 54.9 x 71.8 mm, 91 parts (3 on the bottom side), 69 nets.
