CalPlug/EVSE_Smart_Charger/2017-2018 Project/Smartenit_Board_I2C/Smartenit_Board_Updated.brd

## EAGLE design 2017-2018 Project/Smartenit_Board_I2C/Smartenit_Board_Updated.brd (2018-07-03)

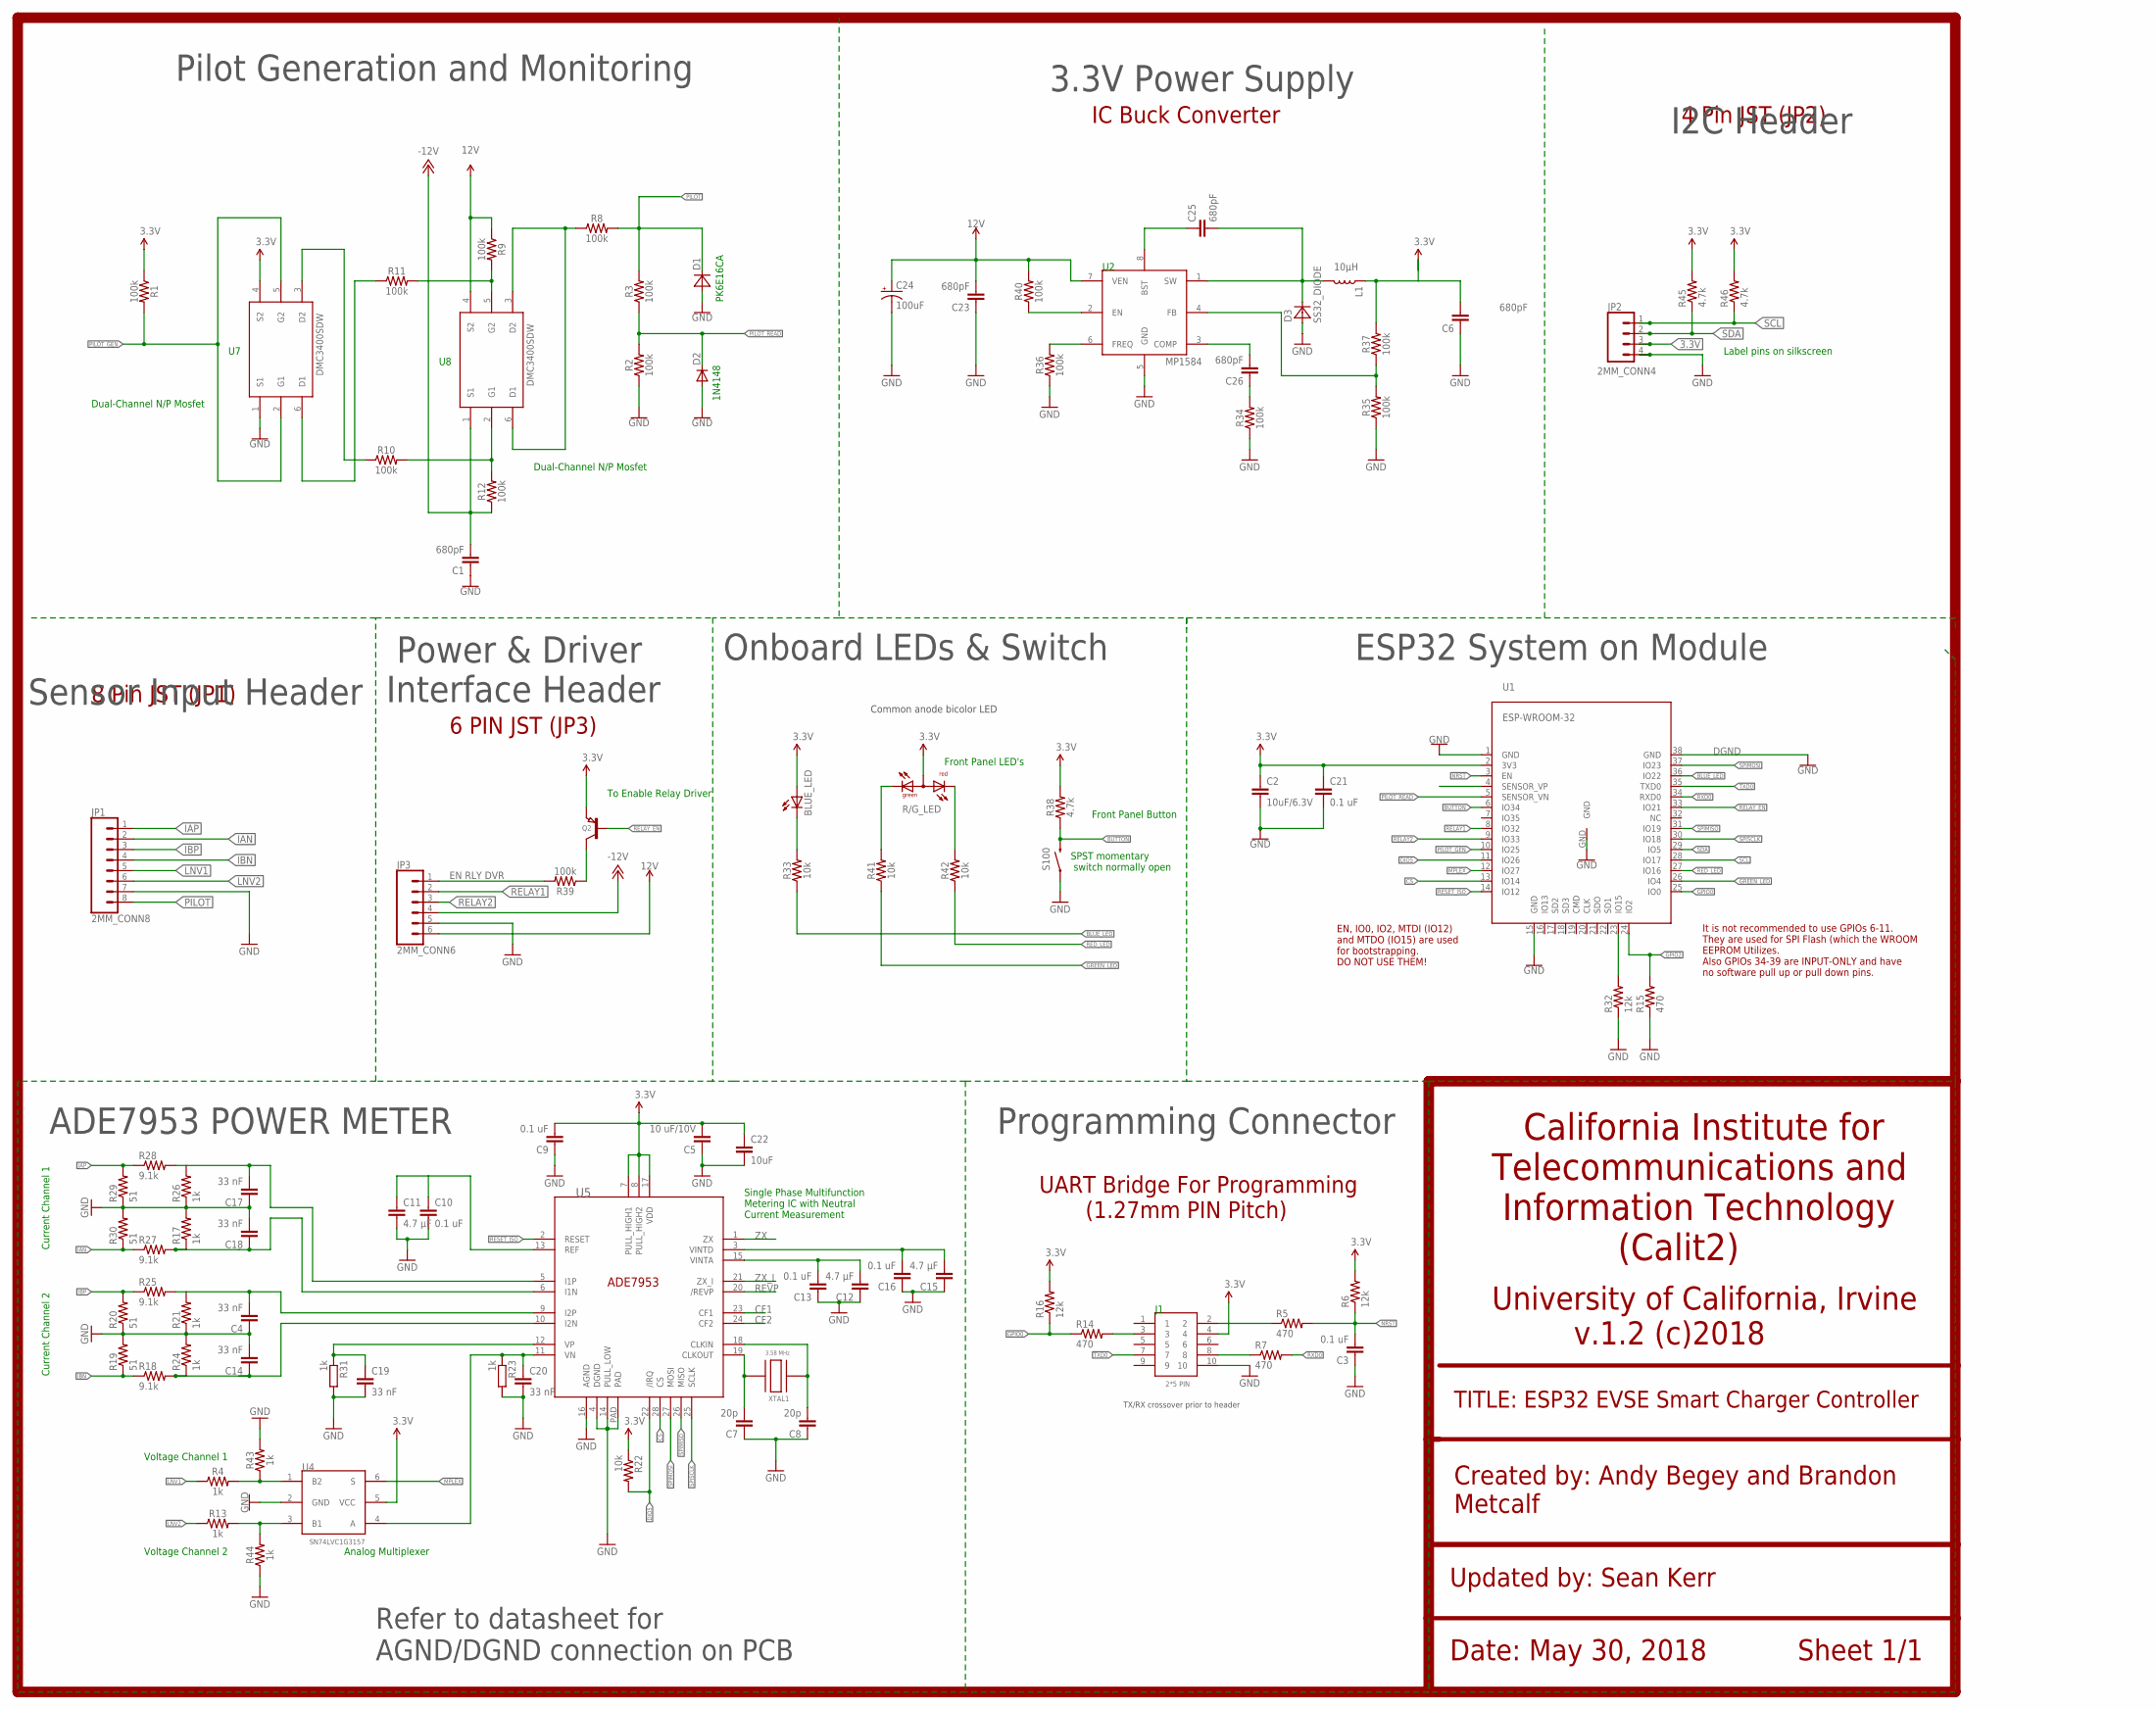
[picture p88: schematic Smartenit_Board_Updated.sch]

Parts:
BLUE_LED: LED3MM
C1, C6, C23, C25, C26: 680pF; 0603
C2: 10uF/6.3V; 0805
C3, C9, C10, C13, C16: 0.1 uF; 0402-CAP
C4, C14, C17, C18: 33 nF; 0402-CAP
C5: 10 uF/10V; 0402-CAP
C7, C8: 20p; 0402-CAP
C11, C12, C15: 4.7 μF; 0402-CAP
C19, C20: 33 nF; C0805K
C21: 0.1 uF; 0603-CAP
C22: 10uF; 0805
C24: 100uF; CPOL-RADIAL-100UF-25V
D1: P6SMB16A; D014AC
D2: DIODESOD; SOD-323
D3: SS32_DIODE; D0-214AB
J1: 2X5CONNECTOR1.27MM; 1296-10
JP1: 2MM_CONN8; CONN82MM
JP2: 2MM_CONN4; CONN4_2MM
JP3: 2MM_CONN6; CONN6_2MM
L1: 47µH/±30%/750mA; CR54
Q2: PNP-TRANSISTOR_SOT23; SOT23
R1, R2, R3, R8, R9, R10, R11, R12, R34, R35, R36, R37, R39, R40: 100k; 0603
R4, R13, R43, R44: 1k; 0603
R5, R7, R14, R15: 470; 0402-RES
R6, R16, R32: 12k; 0402-RES
R17, R21, R24, R26: 1k; 0402-RES
R18, R25, R27, R28: 9.1k; 0402-RES
R19, R20, R29, R30: 51; 0402-RES
R22: 10k; 0402-RES
R23, R31: 1k; 0204V
R33, R41, R42: 10k; 0603
R38: 4.7k; 0603
R45, R46: 4.7k; 0402-RES
R/G_LED: DUOLED-RG-A; DUOLED-A-5MM
S100: SWITCH-MOMENTARY-2PTH; TACTILE-PTH
U1: ESP-WROOM-32
U2: MP1584; SOIC8
U4: SN74LVC1G3157; DBV-6
U5: ADE7953; 28-WFQFN
U7, U8: DMC3400SSDW; SOT363
XTAL1: QUARTZ_3.58M_2PIN; HC-49S

Connections:
3.3V: BLUE_LED.A, C2.1, C5.2, C6.2, C9.2, C21.1, C22.1, J1.4, JP2.3 (PIN3), L1.P$1 (1), Q2.2 (E), R1.1, R6.2, R16.2, R22.1, R37.2, R38.2, R45.2, R46.2, R/G_LED.A, U1.2 (3V3), U4.5 (VCC), U5.7 (PULL_HIGH1), U5.8 (PULL_HIGH2), U5.17 (VDD), U7.4 (S2)
12V: C23.2, C24.1 (+), JP3.6 (PIN6), R9.1, R40.2, U2.7 (VEN), U8.4 (S2)
-12V: C1.2, JP3.4 (PIN4), R12.1, U8.1 (S1)
AGND: C4.1, C10.2, C11.2, C12.1, C13.1, C14.2, C17.1, C18.2, C19.2, C20.2, R17.2, R19.2, R20.1, R21.1, R23.2, R24.2, R26.1, R29.1, R30.2, R31.2, U4.2 (GND), U5.16 (AGND)
BLUE_LED: R33.1, U1.36 (IO22)
BUTTON: R38.1, S100.3 (2), U1.6 (IO34)
CF1: U5.23 (CF1)
CF2: U5.24 (CF2)
CS: U1.13 (IO14), U5.28 (CS)
DGND: C1.1, C2.2, C3.1, C5.1, C6.1, C7.1, C8.1, C9.1, C15.1, C16.1, C21.2, C22.2, C23.1, C24.2 (-), D1.P, D2.2 (A), D3.P, J1.10, JP2.4 (PIN4), JP3.5 (PIN5), R2.1, R15.1, R32.1, R34.1, R35.1, R36.1, R43.2, R44.1, S100.1, U1.1 (GND), U1.15 (GND), U1.38 (GND), U1.GND, U2.5 (GND), U5.4 (DGND), U5.14 (PULL_LOW), U5.PAD, U7.1 (S1)
DIO5: R22.2, U1.11 (IO26), U5.22 (/IRQ)
FRGGN: R32.2, U1.23 (IO15)
GND: JP1.7
GPIO0: R14.1, R16.1, U1.25 (IO0)
GPIO2: R15.2, U1.24 (IO2)
GREEN_LED: R41.1, U1.26 (IO4)
IAN: JP1.2, R27.1, R30.1
IAP: JP1.1, R28.1, R29.2
IBN: JP1.4, R18.1, R19.1
IBP: JP1.3, R20.2, R25.1
LNV1: JP1.5, R4.1
LNV2: JP1.6, R13.1
MPLEX: U1.12 (IO27), U4.6 (S)
unnamed: C7.2, U5.19 (CLKOUT), XTAL1.1
unnamed: C8.2, U5.18 (CLKIN), XTAL1.2
unnamed: C20.1, R23.1, U4.4 (A), U5.11 (VN)
unnamed: R36.2, U2.6 (FREQ)
unnamed: C4.2, R21.2, R25.2, U5.9 (I2P)
unnamed: C10.1, C11.1, U5.13 (REF)
unnamed: C12.2, C13.2, U5.15 (VINTA)
unnamed: R4.2, R43.1, U4.1 (B2)
unnamed: C14.1, R18.2, R24.1, U5.10 (I2N)
unnamed: C15.2, C16.2, U5.3 (VINTD)
unnamed: R13.2, R44.2, U4.3 (B1)
unnamed: R40.1, U2.2 (EN)
unnamed: C26.2, U2.3 (COMP)
unnamed: C26.1, R34.2
unnamed: C25.2, D3.N, L1.P$2 (2), U2.1 (SW)
unnamed: R35.2, R37.1, U2.4 (FB)
unnamed: Q2.3 (C), R39.1
unnamed: BLUE_LED.K (C), R33.2
unnamed: C25.1, U2.8 (BST)
unnamed: R9.2, R11.2, U8.5 (G2)
unnamed: C17.2, R26.2, R28.2, U5.5 (I1P)
unnamed: R41.2, R/G_LED.CX (CG)
unnamed: R42.2, R/G_LED.CR
unnamed: C18.1, R17.1, R27.2, U5.6 (I1N)
unnamed: R10.1, U7.3 (D2)
unnamed: R10.2, R12.2, U8.2 (G1)
unnamed: R11.1, U7.6 (D1)
unnamed: R8.1, U8.3 (D2), U8.6 (D1)
unnamed: JP3.1 (PIN1), R39.2
unnamed: J1.3, R14.2
unnamed: J1.2, R5.1
unnamed: J1.8, R7.1
NRST: C3.2, R5.2, R6.1, U1.3 (EN)
PILOT: D1.N, JP1.8, R3.2, R8.2
PILOT_GEN: R1.2, U1.10 (IO25), U7.2 (G1), U7.5 (G2)
PILOT_READ: D2.1 (C), R2.2, R3.1, U1.5 (SENSOR_VN)
RED_LED: R42.1, U1.27 (IO16)
RELAY1: JP3.2 (PIN2), U1.8 (IO32)
RELAY2: JP3.3 (PIN3), U1.9 (IO33)
RELAY_EN: Q2.1 (B), U1.33 (IO21)
RESET_ISO: U1.14 (IO12), U5.2 (RESET)
REVP: U5.20 (/REVP)
RXD0: R7.2, U1.34 (RXD0)
SCL: JP2.1 (PIN1), R46.1, U1.28 (IO17)
SDA: JP2.2 (PIN2), R45.1, U1.29 (IO5)
SPIMISO: U1.31 (IO19), U5.26 (MISO)
SPIMOSI: U1.37 (IO23), U5.27 (MOSI)
SPISCLK: U1.30 (IO18), U5.25 (SCLK)
TXD0: J1.7, U1.35 (TXD0)
V2P: C19.1, R31.1, U5.12 (VP)
ZX: U5.1 (ZX)
ZX_I: U5.21 (ZX_I)

Notes on the sheet:
EN, IO0, IO2, MTDI (IO12) and MTDO (IO15) are used for bootstrapping. DO NOT USE THEM!
It is not recommended to use GPIOs 6-11. They are used for SPI Flash (which the WROOM EEPROM Utilizes. Also GPIOs 34-39 are INPUT-ONLY and have no software pull up or pull down pins.
Label pins on silkscreen
Common anode bicolor LED
Refer to datasheet for AGND/DGND connection on PCB
EN RLY DVR
3.58 MHz
TITLE: ESP32 EVSE Smart Charger Controller
Created by: Andy Begey and Brandon Metcalf
TX/RX crossover prior to header
California Institute for Telecommunications and Information Technology (Calit2)
University of California, Irvine v.1.2 (c)2018
Date: May 30, 2018 Sheet 1/1
ESP32 System on Module
ADE7953 POWER METER
PK6E16CA
1N4148
SPST momentary switch normally open
Onboard LEDs & Switch
Pilot Generation and Monitoring
Dual-Channel N/P Mosfet
To Enable Relay Driver
Front Panel Button
Front Panel LED's
Voltage Channel 1
Voltage Channel 2
Current Channel 1
Current Channel 2
Analog Multiplexer
Updated by: Sean Kerr
10µH
Single Phase Multifunction Metering IC with Neutral Current Measurement
3.3V Power Supply
IC Buck Converter
I2C Header
4 Pin JST (JP2)
Power & Driver Interface Header
6 PIN JST (JP3)
Sensor Input Header
8 Pin JST (JP1)
Programming Connector
UART Bridge For Programming (1.27mm PIN Pitch)
