CalPlug/EVSE_Smart_Charger/2017-2018 Project/Smartenit_Board_I2C/Smartenit_Board_Updated.brd

## EAGLE design 2017-2018 Project/Smartenit_Board_I2C/Smartenit_Board_Updated.brd (continued)

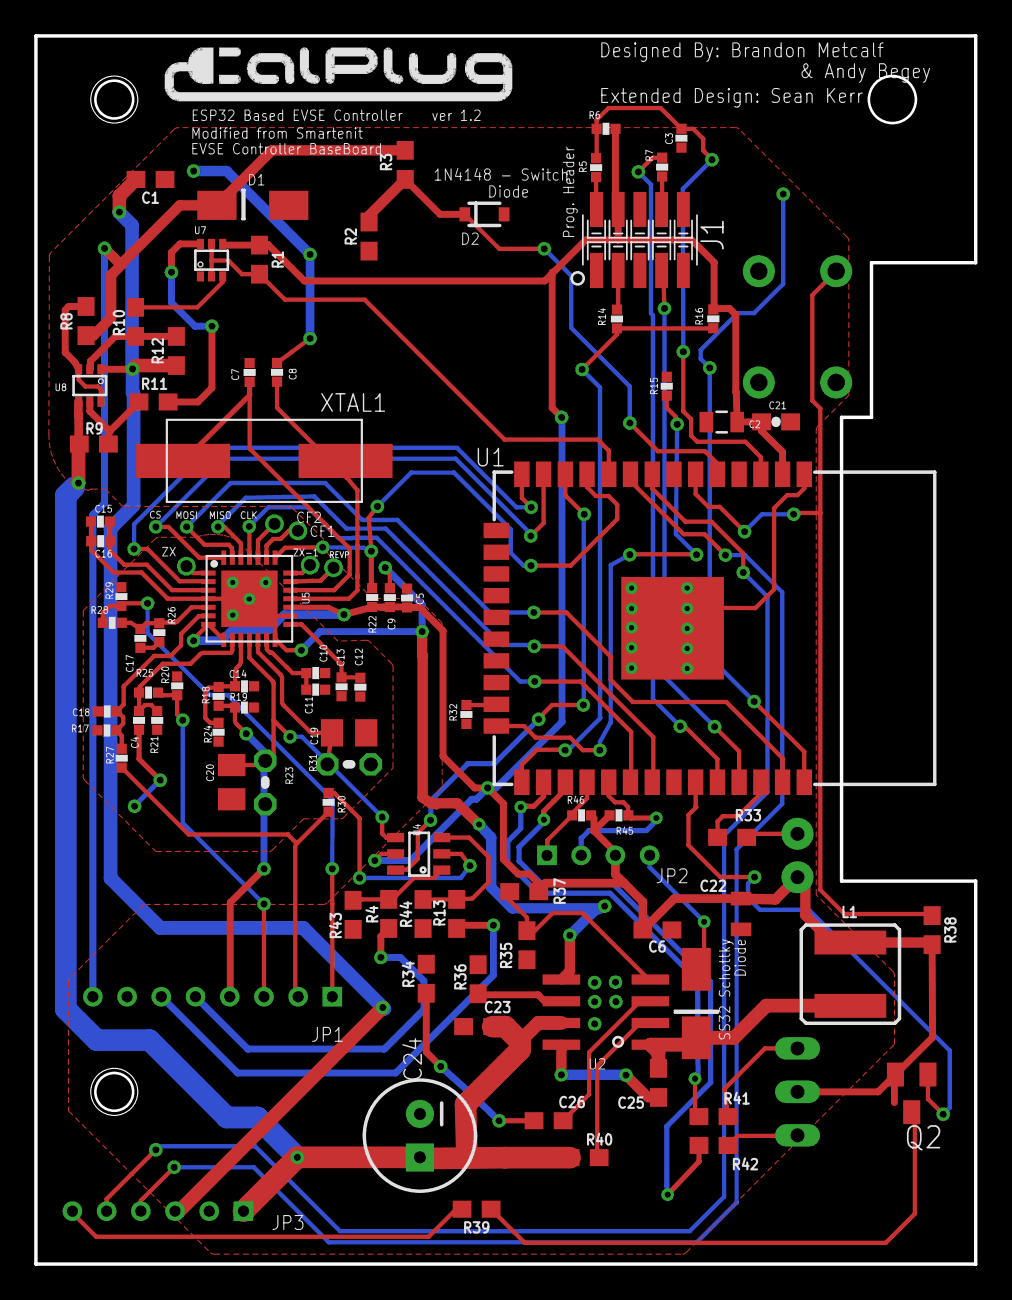
[picture p89: board Smartenit_Board_Updated.brd from above]

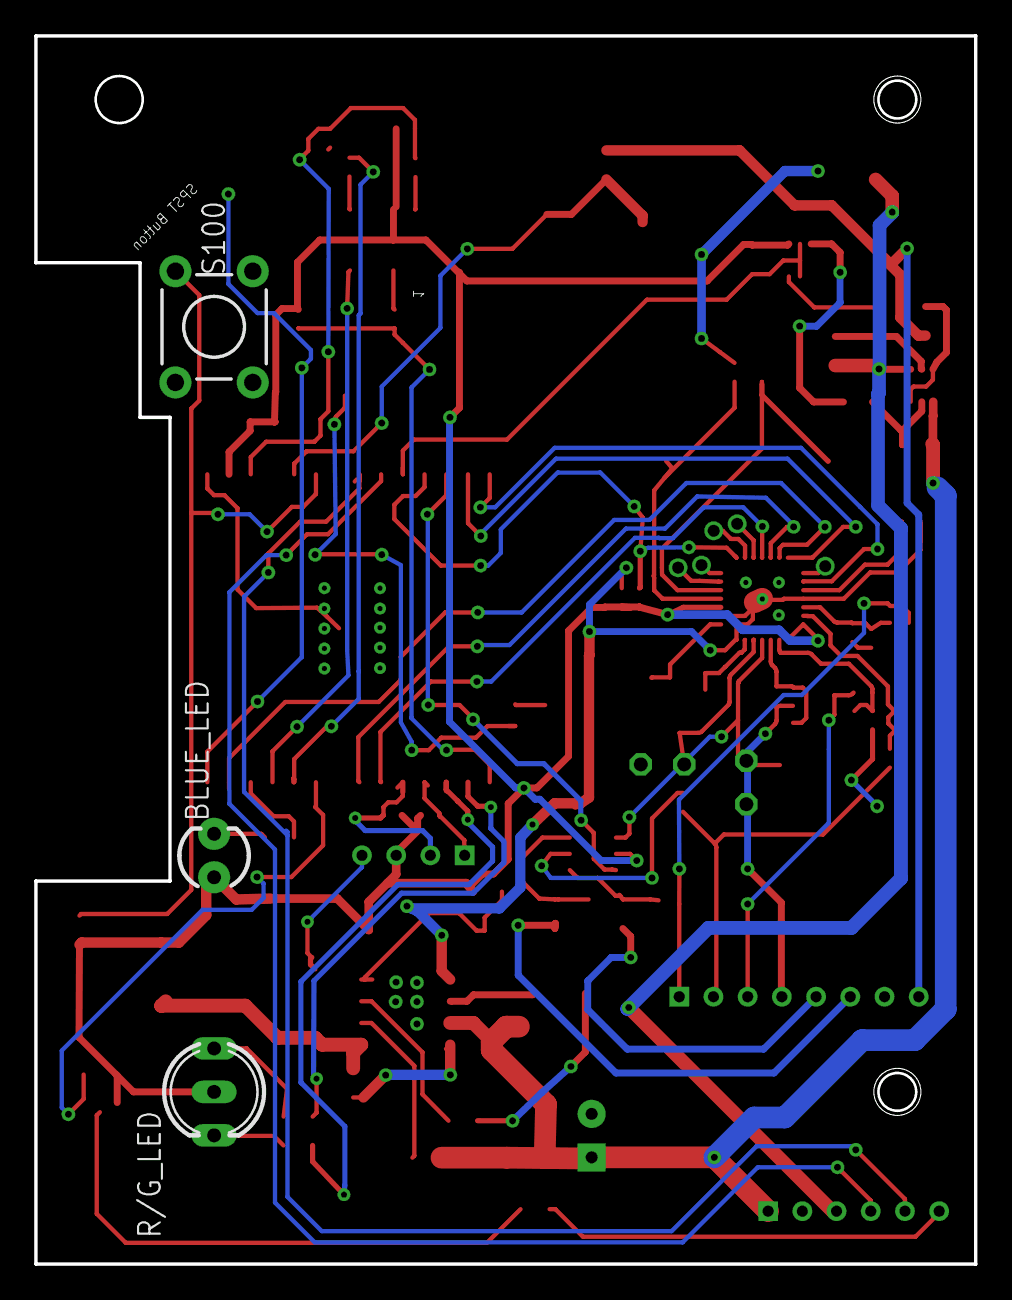
[picture p90: board Smartenit_Board_Updated.brd from below]

Board: 2 copper layers, 54.9 x 71.8 mm, 91 parts (3 on the bottom side), 69 nets.
