CalPlug/EVSE_Smart_Charger/2017-2018 Project/Open_EVSE_Arduino_Code/open_evse-development/src new/open_evse-copy.h

#pragma once
#define OPEN_EVSE
#include <avr/wdt.h>
#include <avr/pgmspace.h>
#include <avr/eeprom.h>
#include <pins_arduino.h>
#include "./Wire.h"
#include "./Time.h"
#include "avrstuff.h"
#include "i2caddr.h"
#if defined(ARDUINO) && (ARDUINO >= 100)
#include "Arduino.h"
#else
#include "WProgram.h" // shouldn't need this but arduino sometimes messes up and puts inside an #ifdef
#endif // ARDUINO
#define VERSION "4.8.0"
#include "Language_default.h"   //Default language should always be included as bottom layer
#define AUTOSVCLEVEL
#define SHOW_DISABLED_TESTS
#define RAPI
#define RAPI_SEQUENCE_ID
#define RAPI_RESPONSE_CHK
#define RAPI_SERIAL
#define WATCHDOG
#define TIME_LIMIT
#define GFI
#define GFI_SELFTEST
#define UL_COMPLIANT
#define UL_GFI_SELFTEST
#define GFI_SELFTEST
#define ADVPWR
#define SAMPLE_ACPINS
#define BTN_MENU
#define BTN_ENABLE_TOGGLE
#define RTC // enable RTC & timer functions
#define DELAYTIMER
#if defined(DELAYTIMER) && defined(BTN_MENU)
#define DELAYTIMER_MENU
#endif
#define PAFC_PWM
#define DEFAULT_LCD_BKL_TYPE BKL_TYPE_MONO
#if defined(SERIALCLI) && defined(DELAYTIMER_MENU)
#error INVALID CONFIG - CANNOT enable SERIALCLI with DELAYTIMER_MENU together - too big
#endif
#if defined(RAPI) && defined(SERIALCLI)
#error INVALID CONFIG - CANNOT DEFINE SERIALCLI AND RAPI TOGETHER SINCE THEY BOTH USE THE SERIAL PORT
#endif
#if defined(OPENEVSE_2) && !defined(ADVPWR)
#error INVALID CONFIG - OPENEVSE_2 implies/requires ADVPWR
#endif
#if defined(UL_COMPLIANT) && !defined(GFI_SELFTEST)
#error INVALID CONFIG - GFI SELF TEST NEEDED FOR UL COMPLIANCE
#endif
#define WATCHDOG_TIMEOUT WDTO_2S
#define LCD_MAX_CHARS_PER_LINE 16
#define TMP_BUF_SIZE ((LCD_MAX_CHARS_PER_LINE+1)*2)
#define DEFAULT_SERVICE_LEVEL 2 // 1=L1, 2=L2
#define DEFAULT_CURRENT_CAPACITY_L1 12
#define DEFAULT_CURRENT_CAPACITY_L2 16
#define MIN_CURRENT_CAPACITY_J1772 6 // J1772 min = 6
#define MIN_CURRENT_CAPACITY_L1 MIN_CURRENT_CAPACITY_J1772
#define MIN_CURRENT_CAPACITY_L2 10
#define MAX_CURRENT_CAPACITY_L1 16 // J1772 Max for L1 on a 20A circuit = 16, 15A circuit = 12
#define MAX_CURRENT_CAPACITY_L2 80 // J1772 Max for L2 = 80
#define CURRENT_PIN 0 // analog current reading pin ADCx
#define PILOT_PIN 1 // analog pilot voltage reading pin ADCx
#define PP_PIN 2 // PP_READ - ADC2
#define ACLINE1_REG &PIND
#define ACLINE1_IDX 3
#define ACLINE2_REG &PIND
#define ACLINE2_IDX 4
#define CHARGING_REG &PINB
#define CHARGING_IDX 0
#define CHARGING2_REG &PIND
#define CHARGING2_IDX 7
#define CHARGINGAC_REG &PINB
#define CHARGINGAC_IDX 1
#define PILOT_REG &PINB
#define PILOT_IDX 2
#define SERIAL_BAUD 115200
#define EOFS_CURRENT_CAPACITY_L1 0 // 1 byte
#define EOFS_CURRENT_CAPACITY_L2 1 // 1 byte
#define EOFS_FLAGS               2 // 2 bytes
#define EOFS_TIMER_FLAGS         4 // 1 byte
#define EOFS_TIMER_START_HOUR    5 // 1 byte
#define EOFS_TIMER_START_MIN     6 // 1 byte
#define EOFS_TIMER_STOP_HOUR     7 // 1 byte
#define EOFS_TIMER_STOP_MIN      8 // 1 byte
#define EOFS_GFI_TRIP_CNT      17 // 1 byte
#define EOFS_NOGND_TRIP_CNT    18 // 1 byte
#define EOFS_STUCK_RELAY_TRIP_CNT 19 // 1 byte
#define EOFS_VOLT_OFFSET 20 // 4 bytes
#define EOFS_VOLT_SCALE_FACTOR 24 // 2 bytes
#define EOFS_THRESH_AMBIENT 26 // 2 bytes
#define EOFS_THRESH_IR 28 // 2 bytes
#define EOFS_LOCAL_I2C_ADDR 30 // 1 byte
#define EOFS_GROUP_CURRENT_CAPACITY 31 // 1 byte
#define EOFS_DUO_NVFLAGS 32 // 1 byte
#define DELAY_STATE_TRANSITION 250
#define DELAY_STATE_TRANSITION_A 25
#define GROUND_CHK_DELAY  1000 // delay after charging started to test, ms
#define STUCK_RELAY_DELAY 1000 // delay after charging opened to test, ms
#define RelaySettlingTime  250 // time for relay to settle in post, ms
#define AC_SAMPLE_MS 20 // 1 cycle @ 60Hz = 16.6667ms @ 50Hz = 20ms
#define GFI_INTERRUPT 0 // interrupt number 0 = PD2, 1 = PD3
#define GFI_REG &PIND
#define GFI_IDX 2
#define GFITEST_REG &PIND
#define GFITEST_IDX 6
#define GFI_TEST_CYCLES 60
#define GFI_PULSE_ON_US 8333 // 1/2 of roughly 60 Hz.
#define GFI_PULSE_OFF_US 8334 // 1/2 of roughly 60 Hz.
#define GFI_TIMEOUT ((unsigned long)(5*60000)) // 15*60*1000 doesn't work. go figure
#define GFI_RETRY_COUNT  6
#define BTN_REG &PINC
#define BTN_IDX 3
#define BTN_PRESS_SHORT 50  // ms
#define BTN_PRESS_LONG 500 // ms
#define BTN_PRESS_VERYLONG 10000
#define DEFAULT_START_HOUR    0x00 //Start time: 00:05
#define DEFAULT_START_MIN     0x05
#define DEFAULT_STOP_HOUR     0x06 //End time: 6:55
#define DEFAULT_STOP_MIN      0x37
#define PILOT_LOOP_CNT 100
typedef union union4b {
  int8_t i8;
  uint8_t u8;
  int16_t i16;
  uint16_t u16;
  int32_t i32;
  uint32_t u32;
  unsigned u;
  int i;
} UNION4B,*PUNION4B;
#define WDT_RESET() wdt_reset() // pat the dog
#define WDT_ENABLE() wdt_enable(WATCHDOG_TIMEOUT)
#include "serialcli.h"
#define OBDF_MONO_BACKLIGHT 0x01
#define OBDF_AMMETER_DIRTY  0x80
#define OBDF_UPDATE_DISABLED 0x40
#define OBD_UPD_NORMAL    0
#define OBD_UPD_FORCE     1 // update even if no state transition
#define OBD_UPD_HARDFAULT 2 // update w/ hard fault
  void DisableUpdate(int8_t on) {
    if (on) m_bFlags |= OBDF_UPDATE_DISABLED;
    else m_bFlags &= ~OBDF_UPDATE_DISABLED;
  }
  int8_t UpdatesDisabled() { return (m_bFlags & OBDF_UPDATE_DISABLED) ? 1 : 0; }
  void Update(int8_t updmode=OBD_UPD_NORMAL); // OBD_UPD_xxx
};
#include "Gfi.h"
#include "J1772Pilot.h"
#include "J1772EvseController.h"
#define BTN_STATE_OFF   0
#define BTN_STATE_SHORT 1 // short press
#define BTN_STATE_LONG  2 // long press
class Btn {
  DigitalPin pinBtn;
  uint8_t buttonState;
  unsigned long lastDebounceTime;  // the last time the output pin was toggled
  unsigned long vlongDebounceTime;  // for verylong press
public:
  Btn();
  void init();
  void read();
  uint8_t shortPress();
  uint8_t longPress();
};
class DelayTimer {
  uint8_t m_DelayTimerEnabled;
  uint8_t m_StartTimerHour;
  uint8_t m_StartTimerMin;
  uint8_t m_StopTimerHour;
  uint8_t m_StopTimerMin;
  uint8_t m_CurrHour;
  uint8_t m_CurrMin;
  unsigned long m_LastCheck;
public:
  DelayTimer(){
    m_LastCheck = - (60ul * 1000ul);
  };
  void Init();
  void CheckTime();
  void Enable();
  void Disable();
  uint8_t IsTimerEnabled(){
    return m_DelayTimerEnabled;
  };
  uint8_t GetStartTimerHour(){
    return m_StartTimerHour;
  };
  uint8_t GetStartTimerMin(){
    return m_StartTimerMin;
  };
  uint8_t GetStopTimerHour(){
    return m_StopTimerHour;
  };
  uint8_t GetStopTimerMin(){
    return m_StopTimerMin;
  };
  void SetStartTimer(uint8_t hour, uint8_t min){
    m_StartTimerHour = hour;
    m_StartTimerMin = min;
    eeprom_write_byte((uint8_t*)EOFS_TIMER_START_HOUR, m_StartTimerHour);
    eeprom_write_byte((uint8_t*)EOFS_TIMER_START_MIN, m_StartTimerMin);
    g_EvseController.SaveSettings();
  };
  void SetStopTimer(uint8_t hour, uint8_t min){
    m_StopTimerHour = hour;
    m_StopTimerMin = min;
    eeprom_write_byte((uint8_t*)EOFS_TIMER_STOP_HOUR, m_StopTimerHour);
    eeprom_write_byte((uint8_t*)EOFS_TIMER_STOP_MIN, m_StopTimerMin);
    g_EvseController.SaveSettings();
  };
  uint8_t IsTimerValid(){
     if (m_StartTimerHour || m_StartTimerMin || m_StopTimerHour || m_StopTimerMin){ // Check not all equal 0
       if ((m_StartTimerHour == m_StopTimerHour) && (m_StartTimerMin == m_StopTimerMin)){ // Check start time not equal to stop time
         return 0;
       } else {
         return 1;
       }
     } else {
       return 0;
     }
  };
  void PrintTimerIcon();
};
char *u2a(unsigned long x,int8_t digits=0);
void ProcessInputs();
#define g_sPlus "+"
#define g_sSlash "/"
#define g_sColon ":"
#define g_sSpace " "
extern DelayTimer g_DelayTimer;
#include "strings.h"
#include "rapi_proc.h"
