CalPlug/EVSE_Smart_Charger/(commit log)

2017-12-30 EVSE Abstract Design
    EVSE Smart Charger Abstract Electronics Design and Connections
2017-12-30 NXP Board update
    Updated airwires and silkscreen collisions
2018-01-08 Added Arduino EVSE Code
2018-01-10 -support for dip switch added
    The light bulb can now be modified into several states by a dip switch.
    Modified the different modes for each state to reflect requests.
2018-01-10 relay test
2018-01-10 removed io expander
    [NXP_Smart_Charger.brd]
2018-01-11 NXP fixes
    [NXP_Smart_Charger.brd, NXP_Smart_Charger.sch]
2018-01-17 -created copies of arduino code
    Made copies, added new folder, adjusted simulator
2018-01-21 added flash memory
    [NXP_Smart_Charger.brd, NXP_Smart_Charger.sch]
2018-01-23 added C conversions
    - conversions for Pilot.h and Pilot.c are added. Need to adjust pin class
2018-01-26 added FCB stuff
    [ENVM.cfg, SF2_MSS_sys_compile_netlist_hier_resources.csv, SF2_MSS_sys_fpga_mapper_hier_area.csv, SF2_MSS_sys_init_config.txt, SF2_MSS_sys_init_config_lock_bits.txt, _vhdl.psm, body.psm, trans.psm]
2018-01-29 uploaded new FPGA design folders
    [ENVM.cfg, SF2_MSS_sys_compile_netlist_hier_resources.csv, SF2_MSS_sys_fpga_mapper_hier_area.csv, SF2_MSS_sys_init_config.txt, SF2_MSS_sys_init_config_lock_bits.txt]
2018-01-31 added software/firmware files
    [SF2_MSS_sys_compile_netlist_hier_resources.csv, SF2_MSS_sys_init_config.txt, SF2_MSS_sys_init_config_lock_bits.txt]
2018-02-14 DC relays on or off
2018-02-14 -state switching
2018-02-16 added smartenit eagle file
    [NXP_Smart_Charger.brd, NXP_Smart_Charger.sch, Smart_Charger (1).brd, Smartenit_Board.sch]
2018-02-18 additions to smartenit schematic
    [Smartenit_Board.brd, Smartenit_Board.sch]
2018-02-19 -added additional MQTT functions
    Device can now respond to certain requests and publish messages
2018-02-21 CHS and LED
    added check state and led state depending on state.
2018-02-21 dimensions changed
    Design changes to base board dimensions
    [Smartenit_Board.brd]
2018-02-21 updated layout
    dimension changes and re-arranging components
    [Smartenit_Board.brd]
2018-02-21 Component Rearrangement
    Rearranged components on board to fit
    [Smartenit_Board.brd]
2018-02-22 New dimensions
    fixed hole spacing and reorganized based on new design
    [Smartenit_Board.brd]
2018-02-22 New dimensnions and lights adjusted
    moved lights to correct position
    [Smartenit_Board.brd]
2018-02-23 button as interrupt
2018-02-23 connecttowifi problems
    implemented 3 led's but couldnt test because it would not upload for some reason smh
    [senior.ino]
2018-02-23 Update dimsension
    updated dimensions and spacing for layout
    [Smartenit_Board.brd, Smartenit_Board.sch]
2018-02-23 -added LED PWM support
2018-02-24 Updated schematic dimensions
    dimensions and interspacing between holes LEDs and pin headers
    [Smartenit_Board.brd, Smartenit_Board.sch]
2018-02-24 changed 2mm headers
    [Smartenit_Board.brd, Smartenit_Board.sch]
2018-02-24 new positions and dimensions
    updated new part positions and new dimensions for holes and headers
    [Smartenit_Board.brd]
2018-02-24 new update
    moved resistor
    [Smartenit_Board.brd]
2018-02-24 Revert "new update"
    This reverts commit 66083c590e8f695bb00e8bd9e9dbc0c4c991c1d6.
    [Smartenit_Board.brd]
2018-02-24 Revert "new positions and dimensions"
    This reverts commit 1058d715852c857a229c7a035a971a2650f9524b.
    [Smartenit_Board.brd]
2018-02-24 revert attempt 3
    [Smartenit_Board.brd, Smartenit_Board.sch]
2018-02-24 Revert "Updated schematic dimensions"
    This reverts commit 3cdf2f2f25e8d79ca338aabb6b6922afd7b4b7ff.
    [Smartenit_Board.brd, Smartenit_Board.sch]
2018-02-24 Revert "changed 2mm headers"
    This reverts commit 813b977e52fbc36cb1bd6f6e005be8e5b7ce1752.
    [Smartenit_Board.brd, Smartenit_Board.sch]
2018-02-24 new no error
    [Smartenit_Board.brd]
2018-02-24 no error still
    [Smartenit_Board.brd]
2018-02-24 no error
    [Smartenit_Board.brd]
2018-02-24 update (google drive supported now)
    [Smartenit_Board.brd, Smartenit_Board.sch]
2018-02-25 -added button interrupts, fixed bug
    Device can now check number of times button is pressed during five second interval. Fixed bug where program was not uploaded to device
    [senior.ino]
2018-02-26 -added button functionality
    Buttons can now cause different effects on the charger state, including shutting down loads, and reseting the device
    [senior.ino]
2018-02-26 routed board
    routed and added pin connections to ESp module
    [Smartenit_Board.brd, Smartenit_Board.sch]
2018-02-26 moved two caps
    proximity issue reslved with caps by crystal.
    [Smartenit_Board.brd]
2018-02-26 smartenit load device/reset
2018-02-26 changed blue LED
    [Smartenit_Board.brd, Smartenit_Board.sch]
2018-02-26 Finished Routing
    Finished aligning dimensions, routing, fixing trace sizes and fixed cap on 12V line.
    [Smartenit_Board.brd, Smartenit_Board.sch]
2018-02-26 renumber board
    [Smartenit_Board.brd, Smartenit_Board.sch]
2018-02-26 Fixed Silk Screen
    Fixed numbering of components and silk screen
    [Smartenit_Board.brd]
2018-02-27 reset params (reset all)
    [senior.ino]
2018-02-27 Fixed Silk Screen final before sending to Al
    fixed silk screen and renumbered parts
    [Smartenit_Board.brd, Smartenit_Board.sch]
2018-02-28 Changed ground planes
    separated into analog and digital grounds. Rearachnged layout for better coupling.
    [Smartenit_Board.brd, Smartenit_Board.sch]
2018-02-28 minor changes to ground planes
    [Smartenit_Board.brd]
2018-02-28 fixed diodes
    [Smartenit_Board.brd, Smartenit_Board.sch]
2018-02-28 New Revision with grounds connected
    [Smartenit_Board.brd, Smartenit_Board.sch]
2018-03-01 fixed right angles, ground planes, connectors
    [Smartenit_Board.brd, Smartenit_Board.sch]
2018-03-01 Made Al's Revision Suggestions
    -no right angles
    -flipped header
    -New digital ground plane (redid ground signals)
    -Reorganized ADE7953 components
    [Smartenit_Board.brd, Smartenit_Board.sch]
2018-03-01 Additional Modifications from Al
    -moved mplex to connector region
    -fixed ground connections to match Als exactly
    -additional reogranization of traces
    [Smartenit_Board.brd, Smartenit_Board.sch]
2018-03-01 updated again
    [Smartenit_Board.brd]
2018-03-01 hole size updated
    [Smartenit_Board.brd]
2018-03-02 -more MQTT functions and LED updates
2018-03-07 - added Pilot Read/ Pilot output
    Device can read ADC values from input pin to determine current state. Will modify the board's state automatically to reflect the input voltage. Can also generate a pilot output signal for the car to receive. Can be modified through MQTT.
2018-03-19 Rerouting for new pins
    [Smartenit_Board.brd, Smartenit_Board.sch]
2018-03-25 -Added Wattmeter libraries for ESP32
2018-03-26 fixed MPLEX package, reverses L1/L2 lines
    [Smartenit_Board.brd, Smartenit_Board.sch]
2018-03-27 fixed more bugs, removed personal information
    [brandy_test.ino, dimswitch_test.ino]
2018-03-27 -fixed ranges for ADC
    [brandy_test.ino]
2018-03-27 -merged AP mode with Brandytest. Still a little buggy
    [brandy_testwithAP.ino]
2018-03-29 Update current channel calibrations
2018-03-30 Added CF1 and CF2 test points
    Last edit for board design for smartenit
    [Smartenit_Board.brd, Smartenit_Board.sch]
2018-03-30 last edits
    [Smartenit_Board.brd]
2018-03-30 cf1 AND cf2
    [Smartenit_Board.brd]
2018-03-30 Last edits
    Added grounds for new resistors and added test points for REVP, ZX, and ZX_I
    [Smartenit_Board.brd, Smartenit_Board.sch]
2018-04-02 updated cap sizes
    [Smartenit_Board.brd, Smartenit_Board.sch]
2018-04-17 -fixed EEPROM reset, adjusted AP mode
    [brandy_testEEPROM.ino, initialize_EEPROM.ino]
2018-04-19 -fixed button bug
2018-04-19 -changed SSID of AP, light bug fix
    [brandy_testEEPROM.ino]
2018-04-24 -fixed AP special characters
    [brandy_testEEPROM.ino]
2018-05-03 added JP2 header
    [Smartenit_Board.brd, Smartenit_Board.sch]
2018-05-03 added notes
    [Smartenit_Board.sch]
2018-05-03 added dot for programming header
    [Smartenit_Board.brd]
2018-05-03 fixed labeling and other stuff
    [Smartenit_Board.brd, Smartenit_Board.sch]
2018-05-16 changes to brandy_testeeprom and pull down
    changed pull down on button to 4.7.
    [Smartenit_Board.brd, Smartenit_Board.sch]
2018-05-30 Update Matlab GUI Code
    [AvailablePower.xls, AvailablePower.xlsx]
2018-05-30 Update with latest Matlab GUI for Serial connection to charger
2018-05-31 Updated BOM
    [Smartenit Board BOM (1) (1).xlsx]
2018-06-01 General fixes
    [ReadPilotdata.xlsx]
2018-06-01 Update Calculations
    [ReadPilotdata.xlsx]
2019-05-31 Upload of 18-19 EVSE firmware
    [Current Sensor Calibration.xlsx, Current Sensor Calibration_Voltage_Current_PowerFactor.xlsx, ENVM.cfg, Microsemi Board BOM.xlsx, NXP_Smart_Charger.brd, NXP_Smart_Charger.sch, ReadPilotdata.xlsx, ReadPilotdata_extended.xlsx]
